RoverLabUNLP/PCB/poncho_original_mas_ancho/documentacion/README.md

# Documentación de referencia para el hardware

Copia desde el repositorio CIAA-firmware, incorporada el 02/11/2026 para
consultarla desde este proyecto. Son documentos de referencia y no se
sincronizan automáticamente con el repositorio de firmware.

- `edu-ciaa/`: dimensiones, esquemático y documentación de la EDU-CIAA-NXP,
  además de la hoja de datos y los manuales de la familia LPC43xx.
- `proyecto/`: informe de avance del auto remoto, que incluye componentes,
  conexiones y alimentación. Es una versión anterior y algunas decisiones
  pueden diferir del diseño actual.
- `firmware/`: copia de la guía de drivers y del mapa de pines del firmware.
  Comprobarlos contra el esquemático y la versión vigente del firmware antes
  de fabricar: pueden cambiar y no se actualizan automáticamente.
