RoverLabUNLP/PCB/poncho_original_mas_ancho/documentacion/pines-montaje.md

# Pines macho de P1 y P2

Montar los pines macho por debajo del poncho en estas posiciones. Se conservan
los agujeros y pads de los demás pines para mantener la compatibilidad con el
esquemático de KiCad; esos contactos se dejan sin montar.

- P1: 1, 2, 4, 7, 8, 10, 11, 12, 13, 14, 16, 18, 19, 20, 21, 22, 23, 24, 25, 26, 28, 30, 32, 35, 36, 38, 40.
- P2: 1, 2, 3, 5, 7, 11, 13, 17, 19, 22, 23, 24, 25, 26, 27, 28, 29, 30, 31, 32, 33, 34, 35, 36, 37, 38, 39, 40.

La selección incluye todos los pines conectados a alimentación o masa en el
esquemático, aunque varias masas compartan la misma red. Si cambia el uso de
pines, actualizar las huellas, sus modelos 3D y esta lista antes de fabricar.
