RoverLabUNLP/PCB/poncho_original_mas_ancho/auto_remoto.pdf

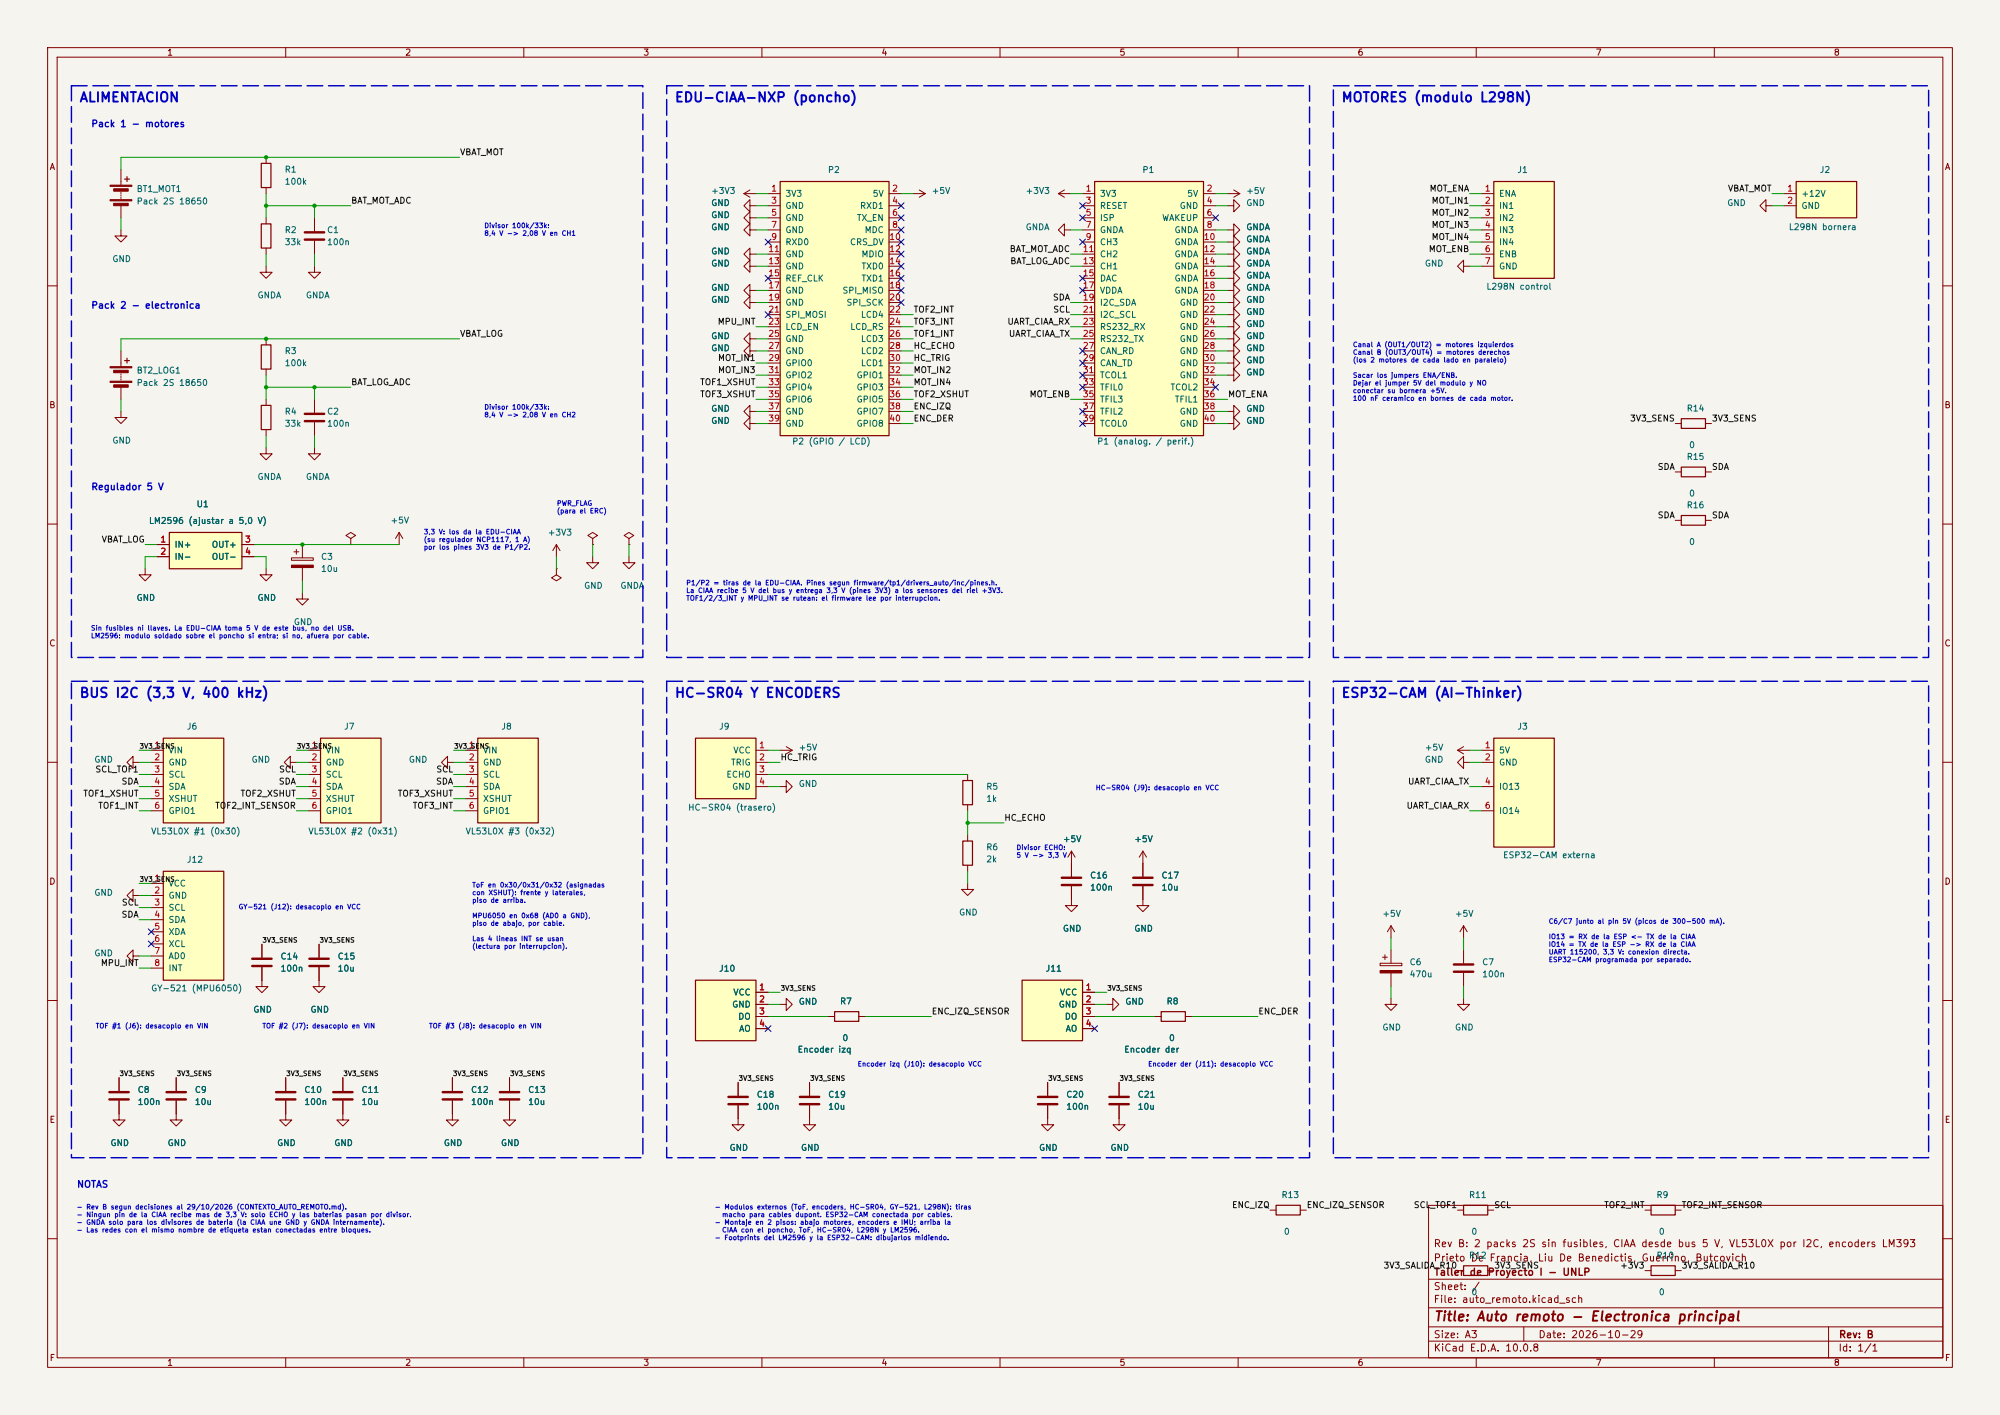
[picture p7: page 1]

EDU-CIAA-NXP (poncho)

GNDA GNDA GNDA GNDA GNDA
GNDA

Canal A (OUT1/OUT2) = motores izquierdos Canal B (OUT3/OUT4) = motores derechos

(los 2 motores de cada lado en paralelo) Sacar los jumpers ENA/ENB. Dejar el jumper 5V del modulo y NO

conectar su bornera +5V. 100 nF ceramico en bornes de cada motor. BUS I2C (3,3 V, 400 kHz)

(para el ERC) 3,3 V: los da la EDU-CIAA

ToF en 0x30/0x31/0x32 (asignadas con XSHUT): frente y laterales, piso de arriba. MPU6050 en 0x68 (AD0 a GND), piso de abajo, por cable. Las 4 lineas INT se usan

GY-521 (J12): desacoplo en VCC

C6/C7 junto al pin 5V (picos de 300-500 mA).

IO13 = RX de la ESP <- TX de la CIAA

TOF #2 (J7): desacoplo en VIN - Rev B segun decisiones al 29/10/2026 (CONTEXTO_AUTO_REMOTO.md). - Ningun pin de la CIAA recibe mas de 3,3 V: solo ECHO y las baterias pasan por divisor. - GNDA solo para los divisores de bateria (la CIAA une GND y GNDA internamente). - Las redes con el mismo nombre de etiqueta estan conectadas entre bloques.

TOF #3 (J8): desacoplo en VIN

Encoder der (J11): desacoplo VCC

Rev B: 2 packs 2S sin fusibles, CIAA desde bus 5 V, VL53L0X por I2C, encoders LM393
Prieto De Francia, Liu De Benedictis, Guerrino, Butcovich
Sheet: /
File: auto_remoto.kicad_sch
Title: Auto remoto - Electronica principal

Size: A3 | Rev: B | F Date: 2026-10-29
KiCad E.D.A. 10.0.8 | Id: 1/1
