RoverLabUNLP/PCB/poncho_original_mas_ancho/respaldo_antes_i2c_R15_R16/auto_remoto.pdf

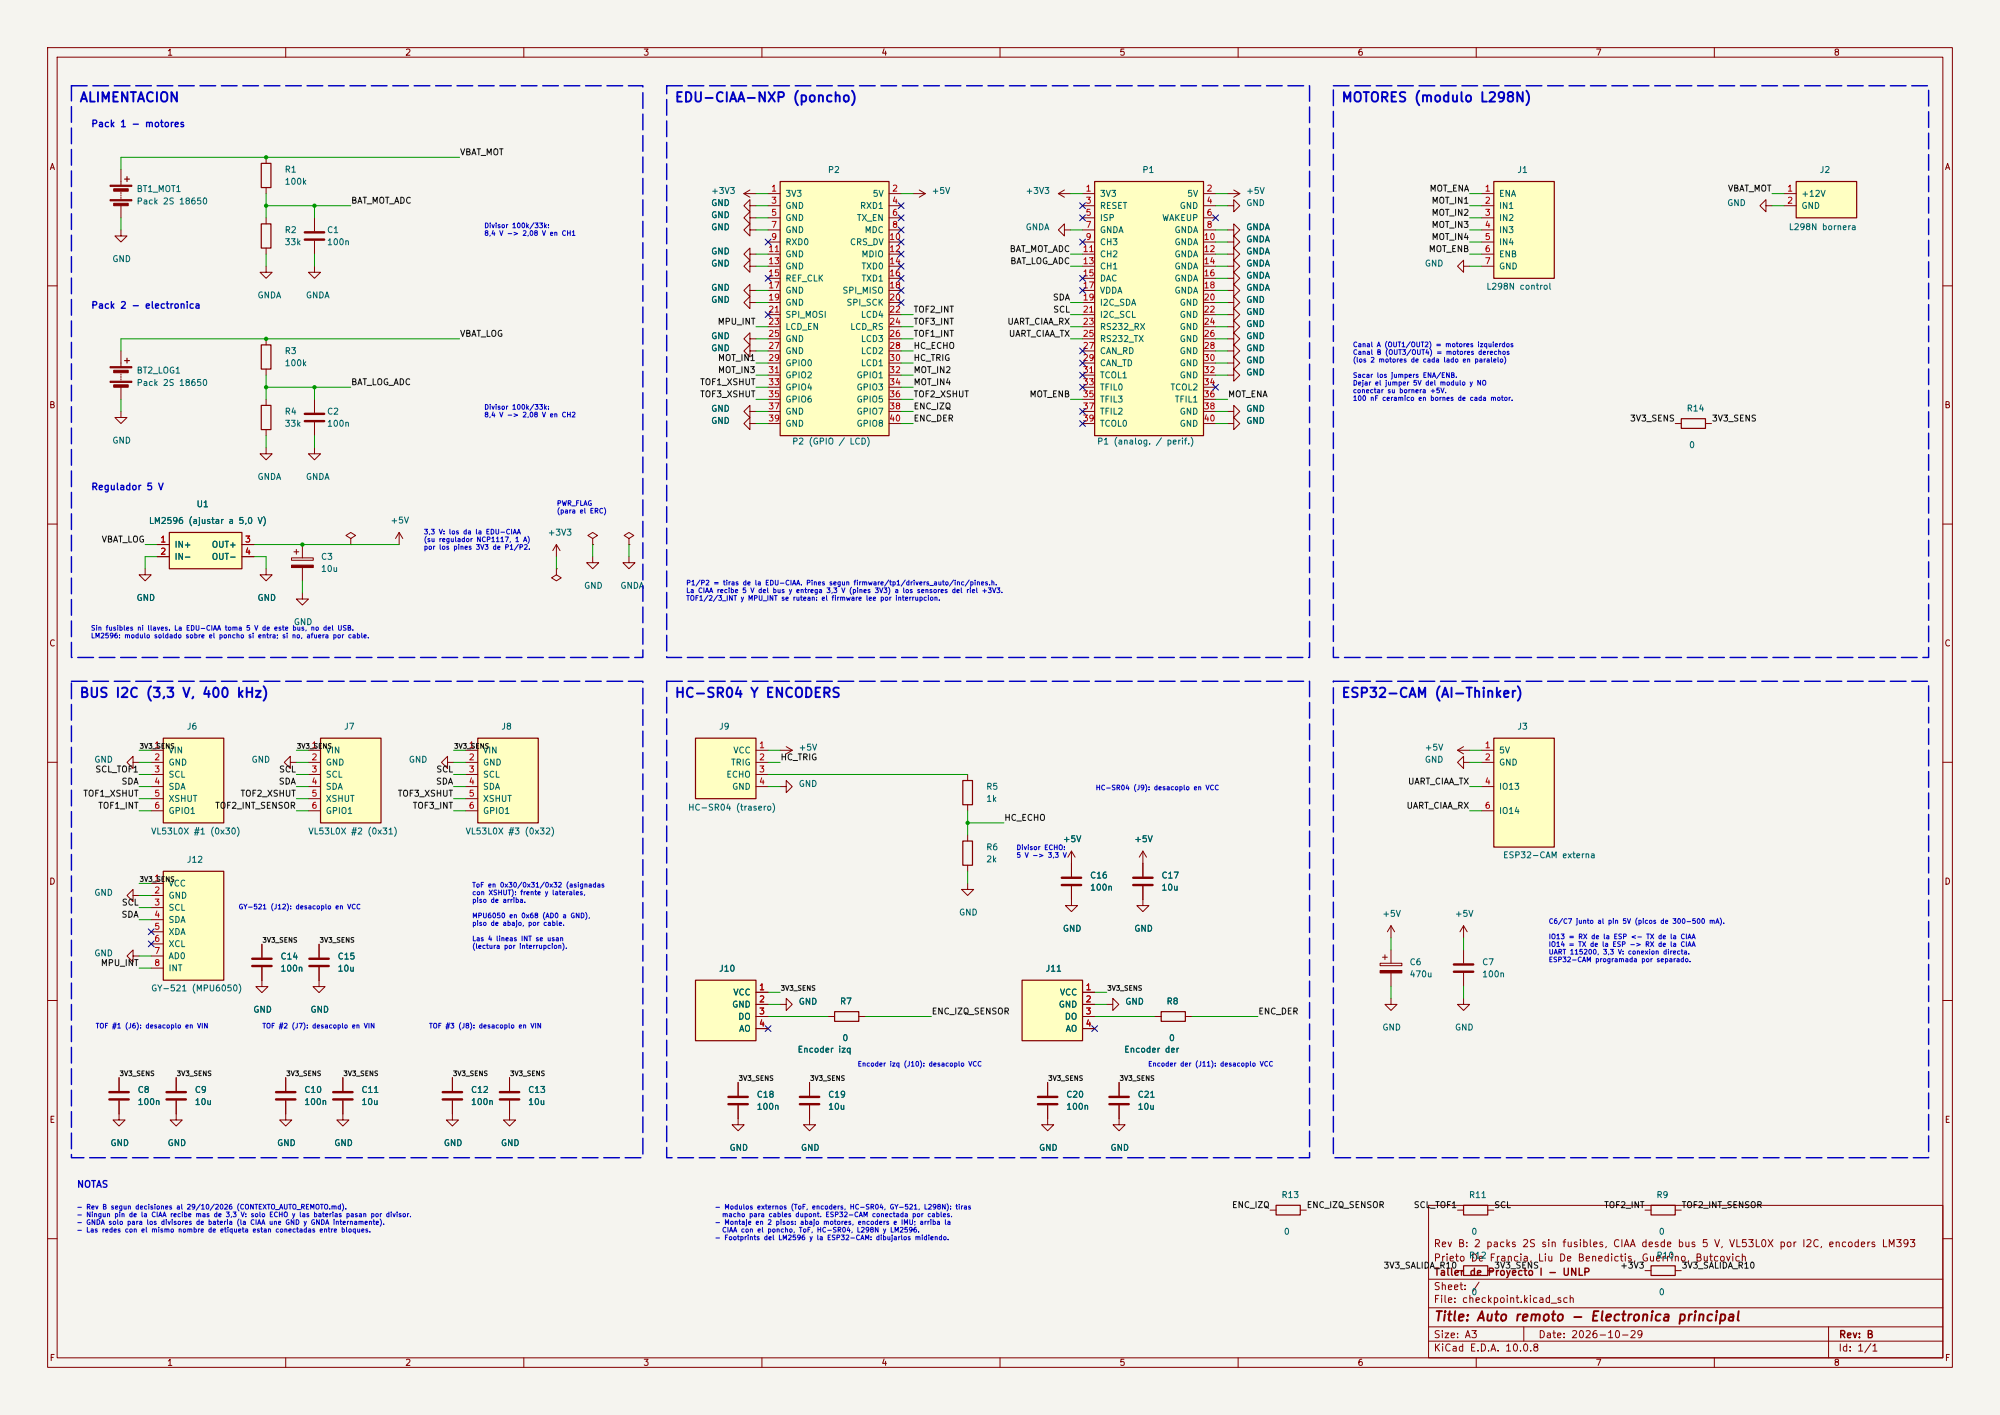
[picture p8: page 1]

P1/P2 = tiras de la EDU-CIAA. Pines segun firmware/tp1/drivers_auto/inc/pines.h. La CIAA recibe 5 V del bus y entrega 3,3 V (pines 3V3) a los sensores del riel +3V3. TOF1/2/3_INT y MPU_INT se rutean: el firmware lee por interrupcion. EDU-CIAA-NXP (poncho)

GND
GNDA GNDA GNDA GNDA GNDA GND

Canal A (OUT1/OUT2) = motores izquierdos Canal B (OUT3/OUT4) = motores derechos

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

conectar su bornera +5V. 100 nF ceramico en bornes de cada motor.

3,3 V: los da la EDU-CIAA
SCL 3
SDA 4

Sin fusibles ni llaves. La EDU-CIAA toma 5 V de este bus, no del USB. LM2596: modulo soldado sobre el poncho si entra; si no, afuera por cable.

TOF #2 (J7): desacoplo en VIN BUS I2C (3,3 V, 400 kHz)

IO14 = TX de la ESP -> RX de la CIAA UART 115200, 3,3 V: conexion directa. ESP32-CAM programada por separado. HC-SR04 (J9): desacoplo en VCC
10u +5V GND

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

GY-521 (J12): desacoplo en VCC

IO13 = RX de la ESP <- TX de la CIAA

TOF #1 (J6): desacoplo en VIN

Encoder der (J11): desacoplo VCC

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

Rev B: 2 packs 2S sin fusibles, CIAA desde bus 5 V, VL53L0X por I2C, encoders LM393
Prieto De Francia, Liu De Benedictis, Guerrino, Butcovich
Sheet: /
File: checkpoint.kicad_sch
Title: Auto remoto - Electronica principal

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
