RoverLabUNLP/PCB/poncho_original_mas_ancho/respaldo_antes_R10/auto_remoto.pdf

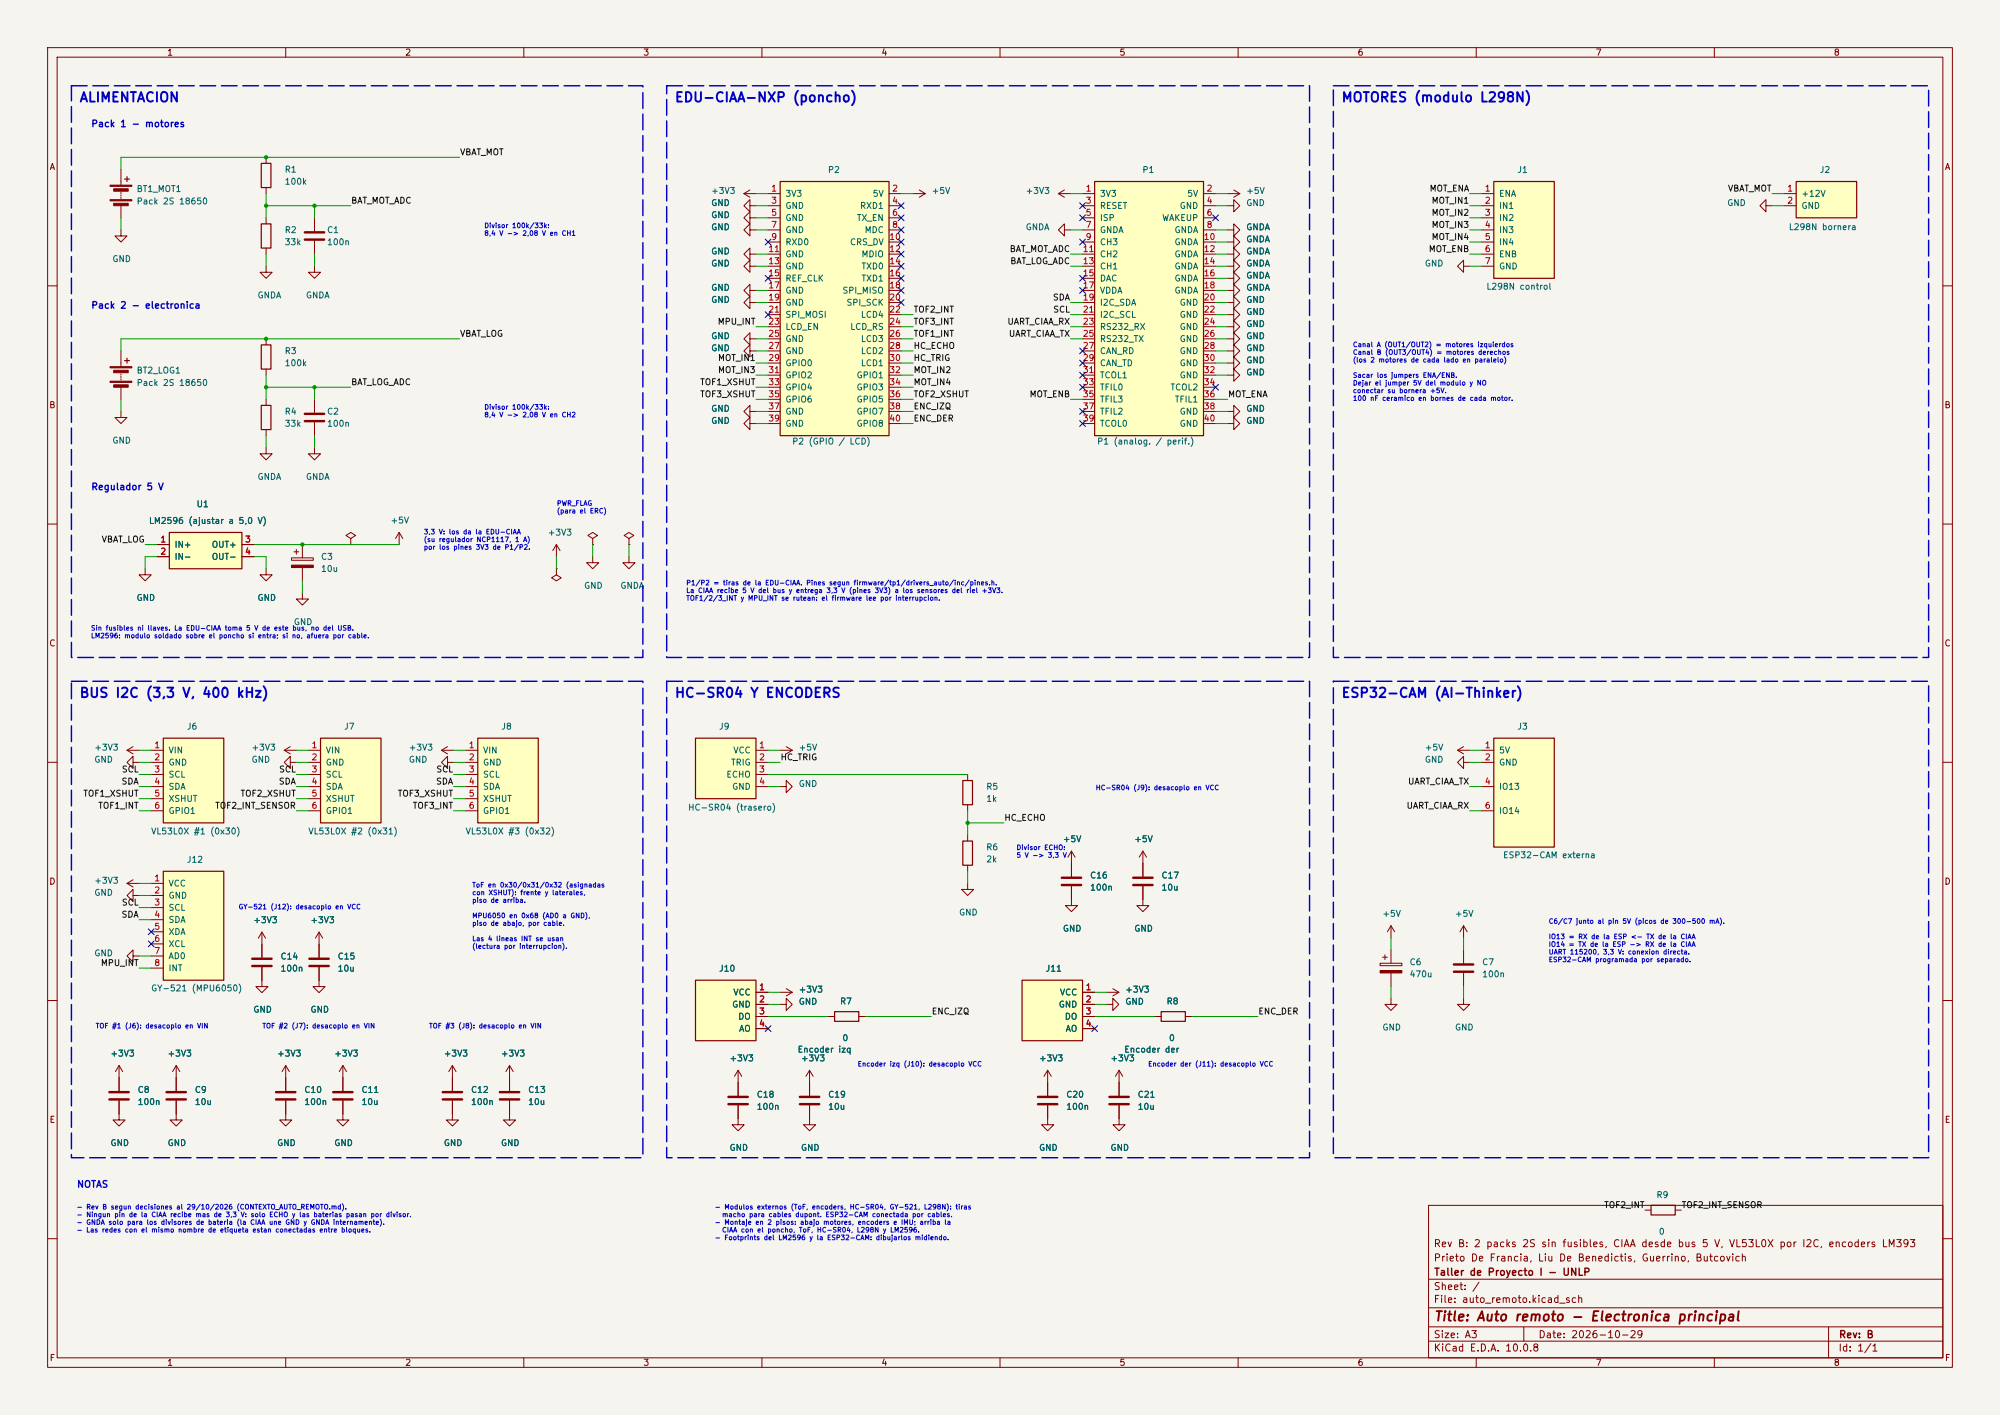
[picture p9: page 1]

Canal A (OUT1/OUT2) = motores izquierdos Canal B (OUT3/OUT4) = motores derechos

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

conectar su bornera +5V. 100 nF ceramico en bornes de cada motor.

3,3 V: los da la EDU-CIAA

IO14 = TX de la ESP -> RX de la CIAA UART 115200, 3,3 V: conexion directa. ESP32-CAM programada por separado. - Modulos externos (ToF, encoders, HC-SR04, GY-521, L298N): tiras macho para cables dupont. ESP32-CAM conectada por cables. - Montaje en 2 pisos: abajo motores, encoders e IMU; arriba la CIAA con el poncho, ToF, HC-SR04, L298N y LM2596. - Footprints del LM2596 y la ESP32-CAM: dibujarlos midiendo. HC-SR04 Y ENCODERS

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

TOF #1 (J6): desacoplo en VIN - Rev B segun decisiones al 29/10/2026 (CONTEXTO_AUTO_REMOTO.md). - Ningun pin de la CIAA recibe mas de 3,3 V: solo ECHO y las baterias pasan por divisor. - GNDA solo para los divisores de bateria (la CIAA une GND y GNDA internamente). - Las redes con el mismo nombre de etiqueta estan conectadas entre bloques. GY-521 (J12): desacoplo en VCC

C6/C7 junto al pin 5V (picos de 300-500 mA).

IO13 = RX de la ESP <- TX de la CIAA

TOF #3 (J8): desacoplo en VIN

Rev B: 2 packs 2S sin fusibles, CIAA desde bus 5 V, VL53L0X por I2C, encoders LM393
Prieto De Francia, Liu De Benedictis, Guerrino, Butcovich
Taller de Proyecto I - UNLP
Sheet: /
File: auto_remoto.kicad_sch
Title: Auto remoto - Electronica principal

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
