RoverLabUNLP/PCB/poncho_original_mas_ancho/respaldo_antes_R9/auto_remoto.pdf

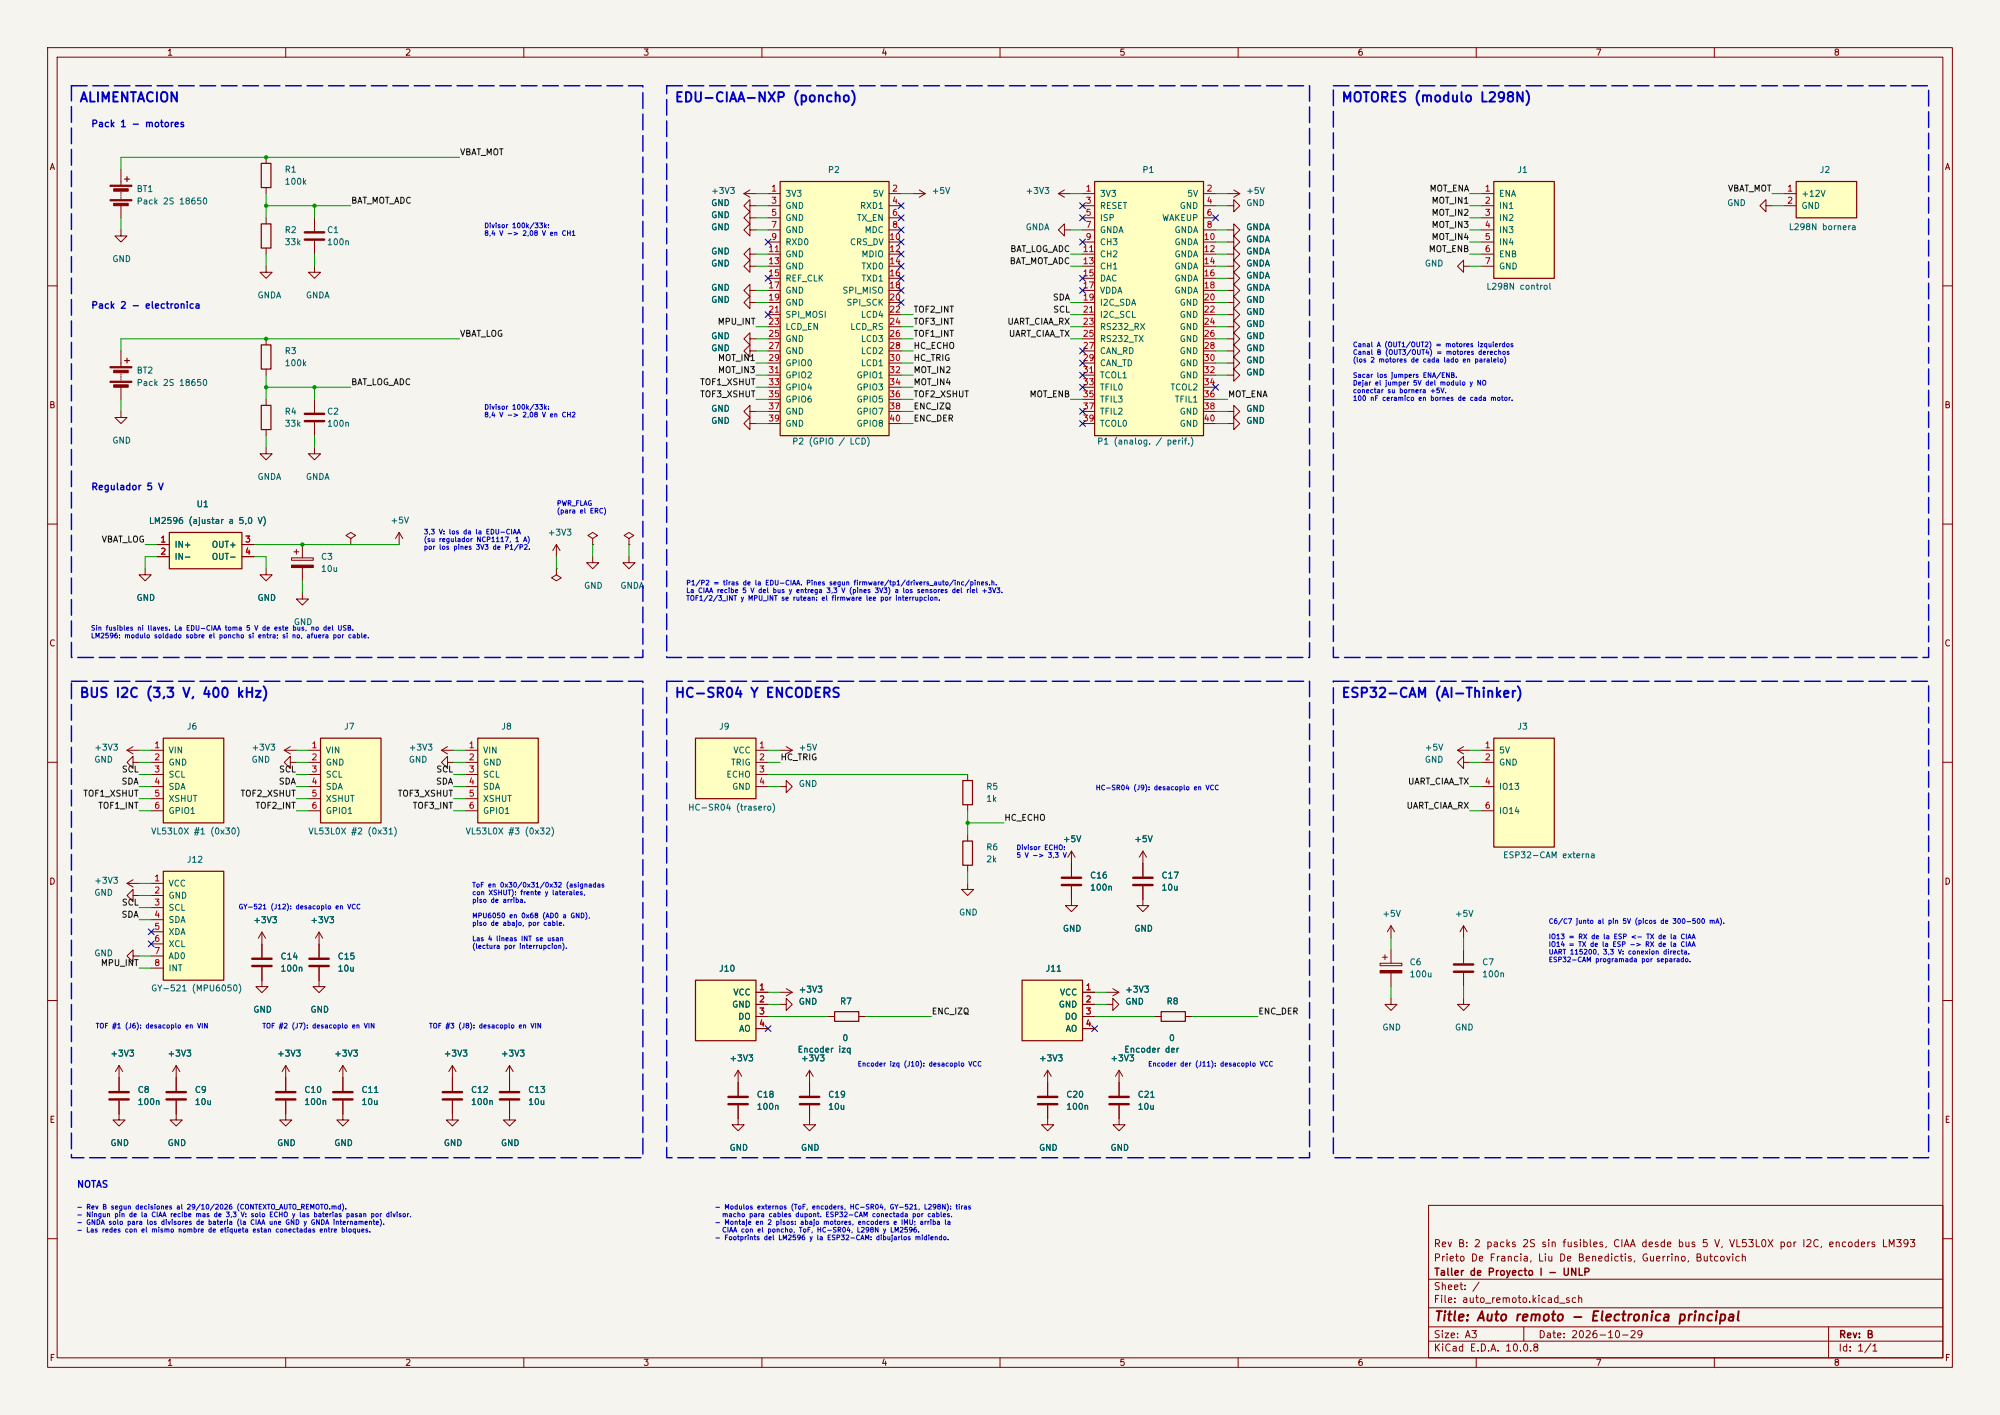
[picture p10: page 1]

EDU-CIAA-NXP (poncho)

conectar su bornera +5V. 100 nF ceramico en bornes de cada motor. MOTORES (modulo L298N)

GND
GNDA GND
GNDA GNDA GNDA GND

GNDA GNDA GNDA GNDA GNDA GND

Canal A (OUT1/OUT2) = motores izquierdos Canal B (OUT3/OUT4) = motores derechos

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

(su regulador NCP1117, 1 A) por los pines 3V3 de P1/P2. Divisor 100k/33k: 8,4 V -> 2,08 V en CH2 PWR_FLAG

3,3 V: los da la EDU-CIAA

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

HC-SR04 (J9): desacoplo en VCC

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

GY-521 (J12): desacoplo en VCC

C6/C7 junto al pin 5V (picos de 300-500 mA).

IO13 = RX de la ESP <- TX de la CIAA

IO14 = TX de la ESP -> RX de la CIAA UART 115200, 3,3 V: conexion directa. ESP32-CAM programada por separado. Encoder der (J11): desacoplo VCC

TOF #1 (J6): desacoplo en VIN

TOF #2 (J7): desacoplo en VIN

TOF #3 (J8): desacoplo en VIN

Encoder izq C18
Encoder izq (J10): desacoplo VCC - Modulos externos (ToF, encoders, HC-SR04, GY-521, L298N): tiras macho para cables dupont. ESP32-CAM conectada por cables. - Montaje en 2 pisos: abajo motores, encoders e IMU; arriba la CIAA con el poncho, ToF, HC-SR04, L298N y LM2596. - Footprints del LM2596 y la ESP32-CAM: dibujarlos midiendo.

- Rev B segun decisiones al 29/10/2026 (CONTEXTO_AUTO_REMOTO.md). - Ningun pin de la CIAA recibe mas de 3,3 V: solo ECHO y las baterias pasan por divisor. - GNDA solo para los divisores de bateria (la CIAA une GND y GNDA internamente). - Las redes con el mismo nombre de etiqueta estan conectadas entre bloques. NOTAS

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
