RoverLabUNLP/PCB/poncho_original_mas_ancho/documentacion/edu-ciaa/EDU-CIAA-NXP Esquematico_v2.pdf

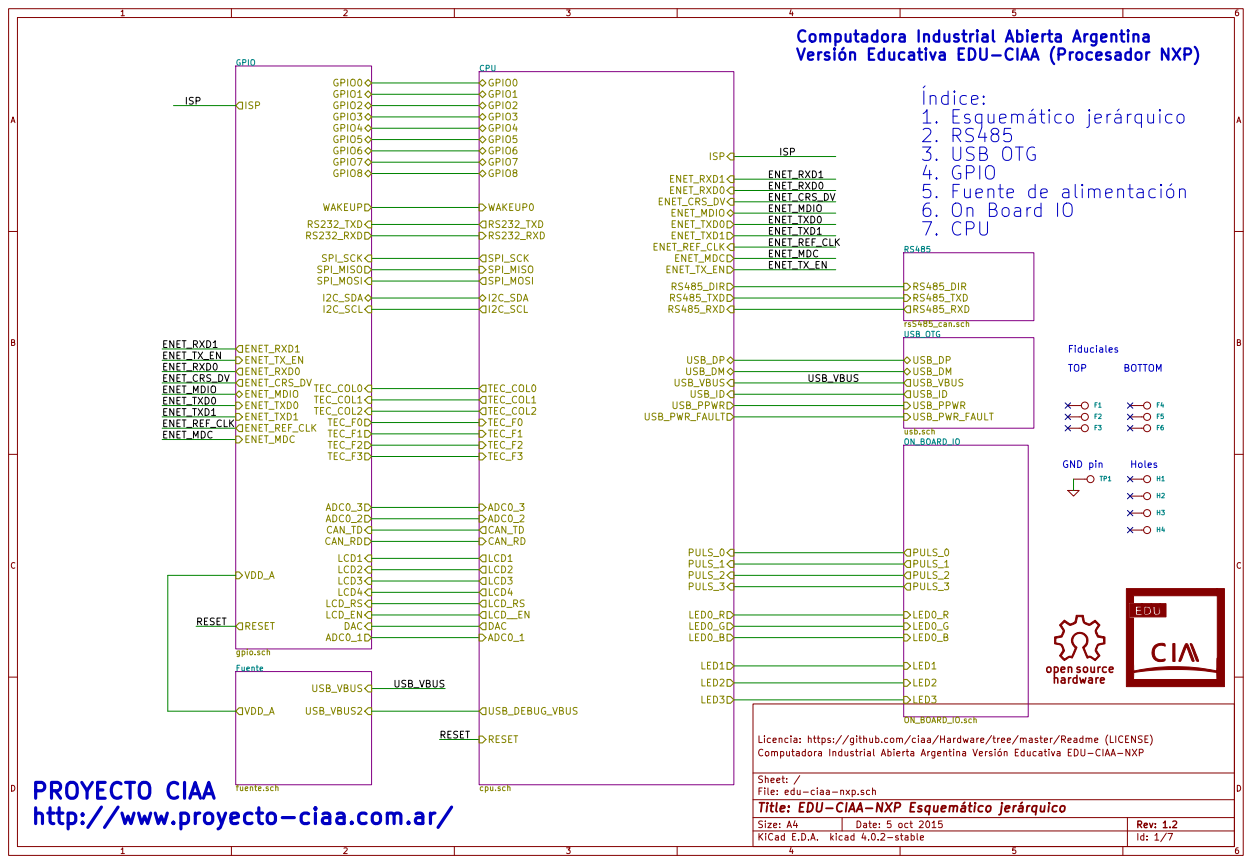
[picture p11: page 1]

LED3 Computadora Industrial Abierta Argentina
Versión Educativa EDU-CIAA (Procesador NXP)

ENET_RXD0
ENET_CRS_DV

ENET_TX_EN
ENET_MDIO
ENET_TXD0
ENET_TXD1
ENET_REF_CLK
ENET_MDC

Licencia: https://github.com/ciaa/Hardware/tree/master/Readme (LICENSE)
File: edu-ciaa-nxp.sch Sheet: / Computadora Industrial Abierta Argentina Versión Educativa EDU-CIAA-NXP

PROYECTO CIAA
http://www.proyecto-ciaa.com.ar/

Id: 1/7 Title: EDU-CIAA-NXP Esquemático jerárquico

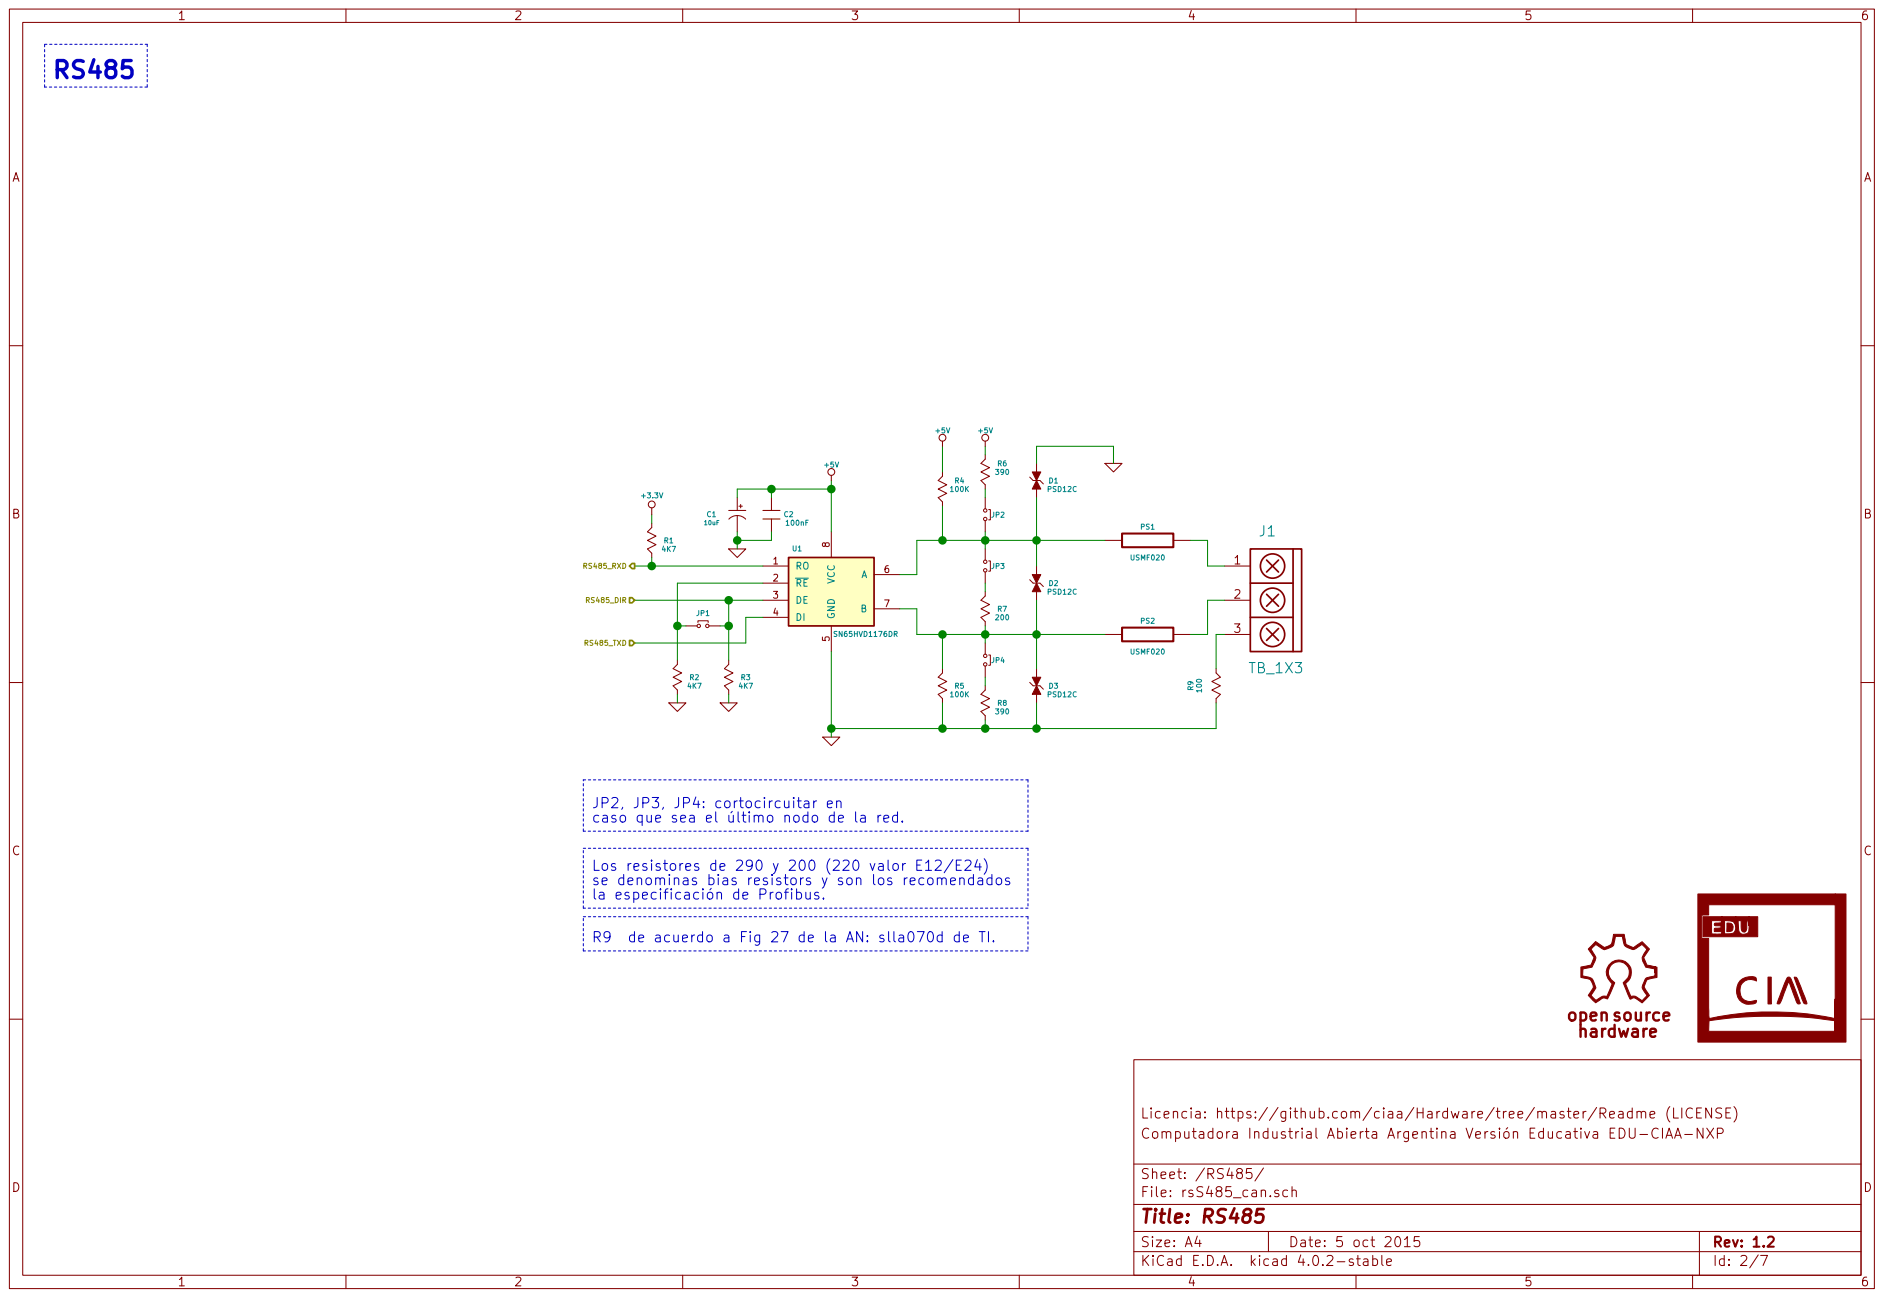
[picture p12: page 2]

la especificación de Profibus. R1
4K7 RS485_TXD

caso que sea el último nodo de la red. R3

Los resistores de 290 y 200 (220 valor E12/E24)
se denominas bias resistors y son los recomendados

open source R9 de acuerdo a Fig 27 de la AN: slla070d de TI.

Licencia: https://github.com/ciaa/Hardware/tree/master/Readme (LICENSE)
File: rsS485_can.sch Sheet: /RS485/ Computadora Industrial Abierta Argentina Versión Educativa EDU-CIAA-NXP

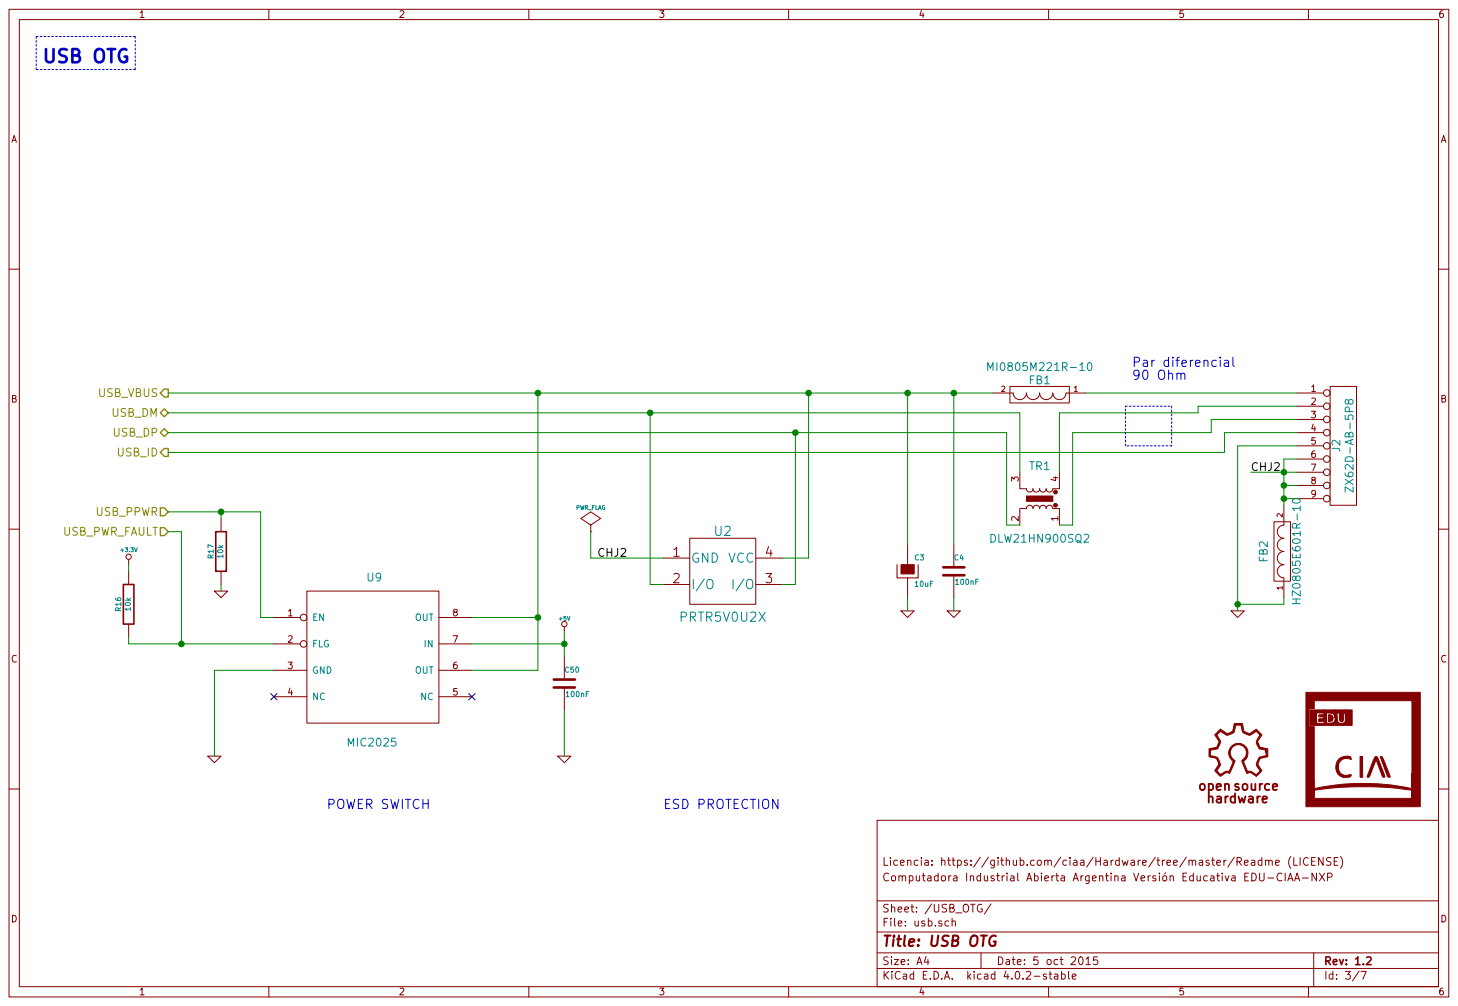
[picture p13: page 3]

open source USB OTG

Licencia: https://github.com/ciaa/Hardware/tree/master/Readme (LICENSE)
Computadora Industrial Abierta Argentina Versión Educativa EDU-CIAA-NXP

File: usb.sch Sheet: /USB_OTG/
Id: 3/7 Title: USB OTG

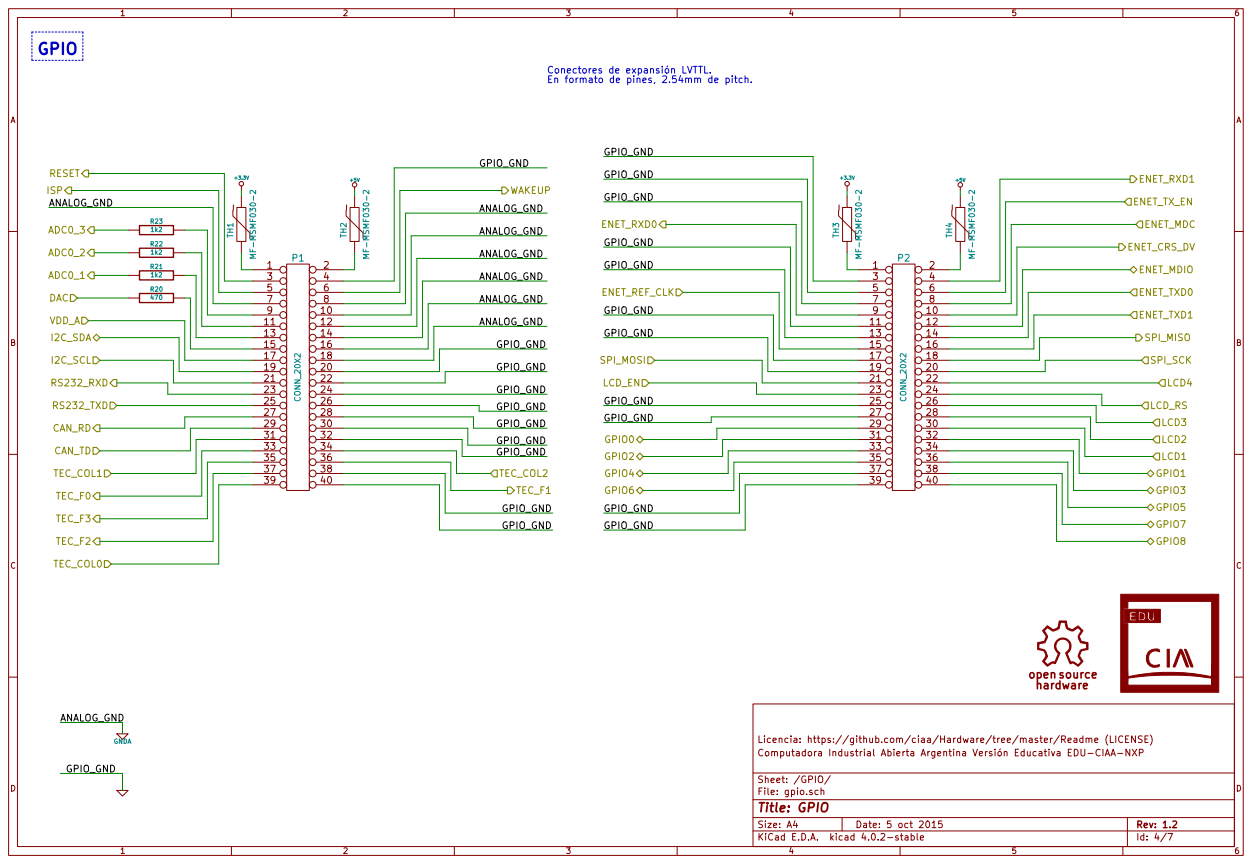
[picture p14: page 4]

Conectores de expansión LVTTL.
En formato de pines, 2.54mm de pitch.

Licencia: https://github.com/ciaa/Hardware/tree/master/Readme (LICENSE)
File: gpio.sch Sheet: /GPIO/ Computadora Industrial Abierta Argentina Versión Educativa EDU-CIAA-NXP

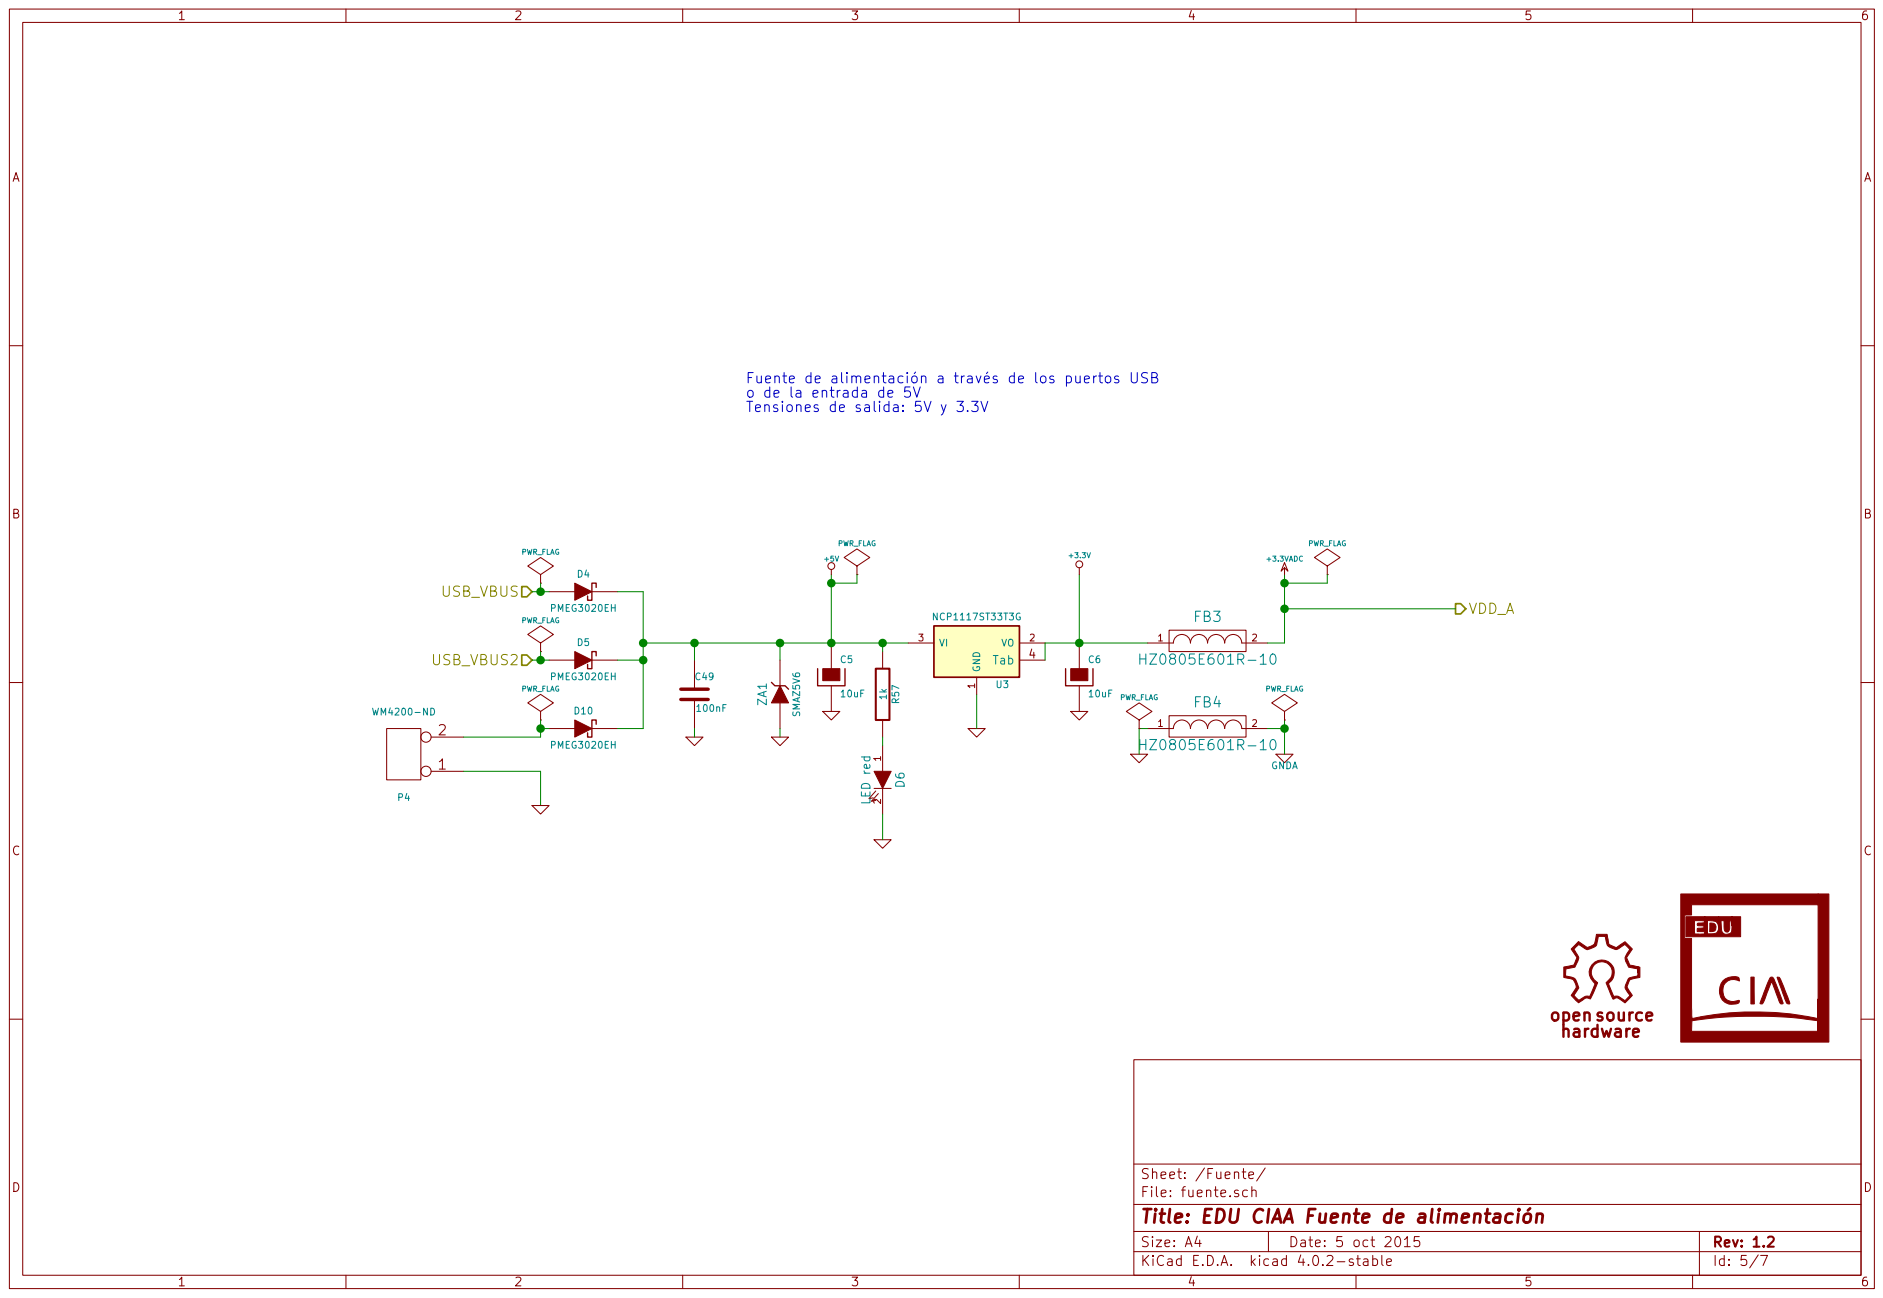
[picture p15: page 5]

1 2 D6 LED red R57 1k Fuente de alimentación a través de los puertos USB
o de la entrada de 5V Tensiones de salida: 5V y 3.3V

File: fuente.sch Sheet: /Fuente/
Id: 5/7 Title: EDU CIAA Fuente de alimentación

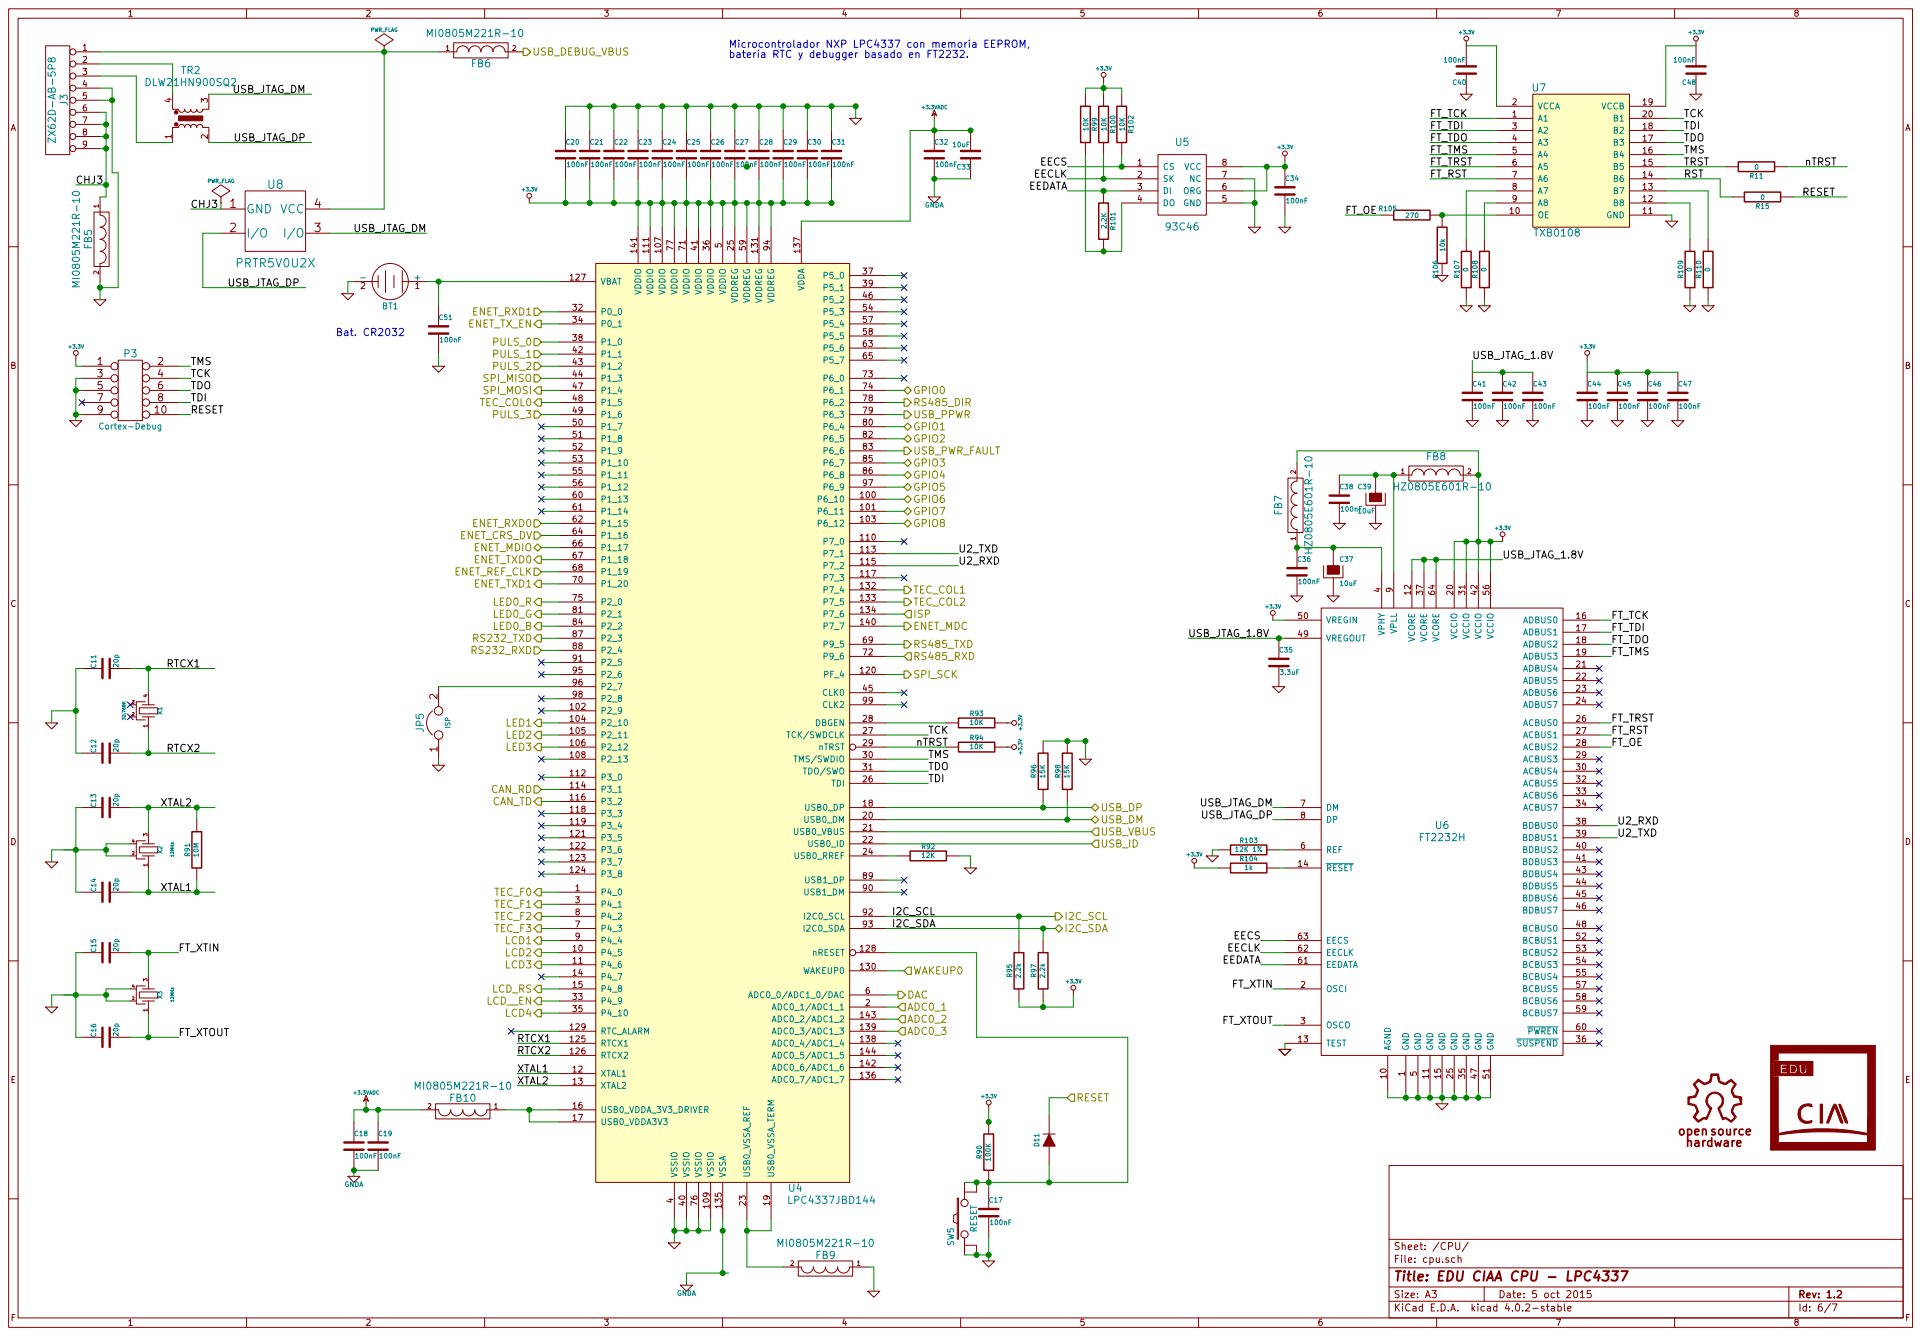
[picture p16: page 6]

batería RTC y debugger basado en FT2232.

FT_TMS | 20 GND 16 B3

FT_TRST | | 15 B4
FT_RST | 14 B5

5 ADC0_0/ADC1_0/DAC 6 P4_3 7 P4_2 8 P4_4 9 P4_5 10 USB0_DM 20 TMS/SWDIO 30 VSSIO 40 P1_7 50 P1_13 60 P1_20 70 P6_4 80 USB1_DM 90 P4_6 11 USB0_VBUS 21 TDO/SWO 31 VDDIO 41 P1_8 51 P1_14 61 VDDIO 71 P2_1 81 P2_5 91 XTAL1 12 USB0_ID 22

9 AGND 10 VCCIO 20 ACBUS4 30 BDBUS2 40 VREGIN 50 PWREN 60 GND 11 ADBUS4 21 VCCIO 31 BDBUS3 41 GND 51 EEDATA 61 VCORE 12 ADBUS5 22 ACBUS5 32 VCCIO 42 BCBUS1 52 EECLK 62 TEST 13 ADBUS6 23 ACBUS6 33 BDBUS4 43 BCBUS2 53 EECS 63 RESET 14 ADBUS7 24 ACBUS7 34 BDBUS5 44 BCBUS3 54 VCORE 64 GND 15 GND 25 GND 35 BDBUS6 45 BCBUS4 55 ADBUS0 16 ACBUS0 26 SUSPEND 36 BDBUS7 46 VCCIO 56 ADBUS1 17 ACBUS1 27 VCORE 37 GND 47 BCBUS5 57 ADBUS2 18 ACBUS2 28 BDBUS0 38 BCBUS0 48 BCBUS6 58 ADBUS3 19 ACBUS3 29 BDBUS1 39 VREGOUT 49 BCBUS7 59 U6 FT2232H

5 REF 6 DM 7 DP 8 VPLL

File: cpu.sch Sheet: /CPU/
Id: 6/7 Title: EDU CIAA CPU - LPC4337

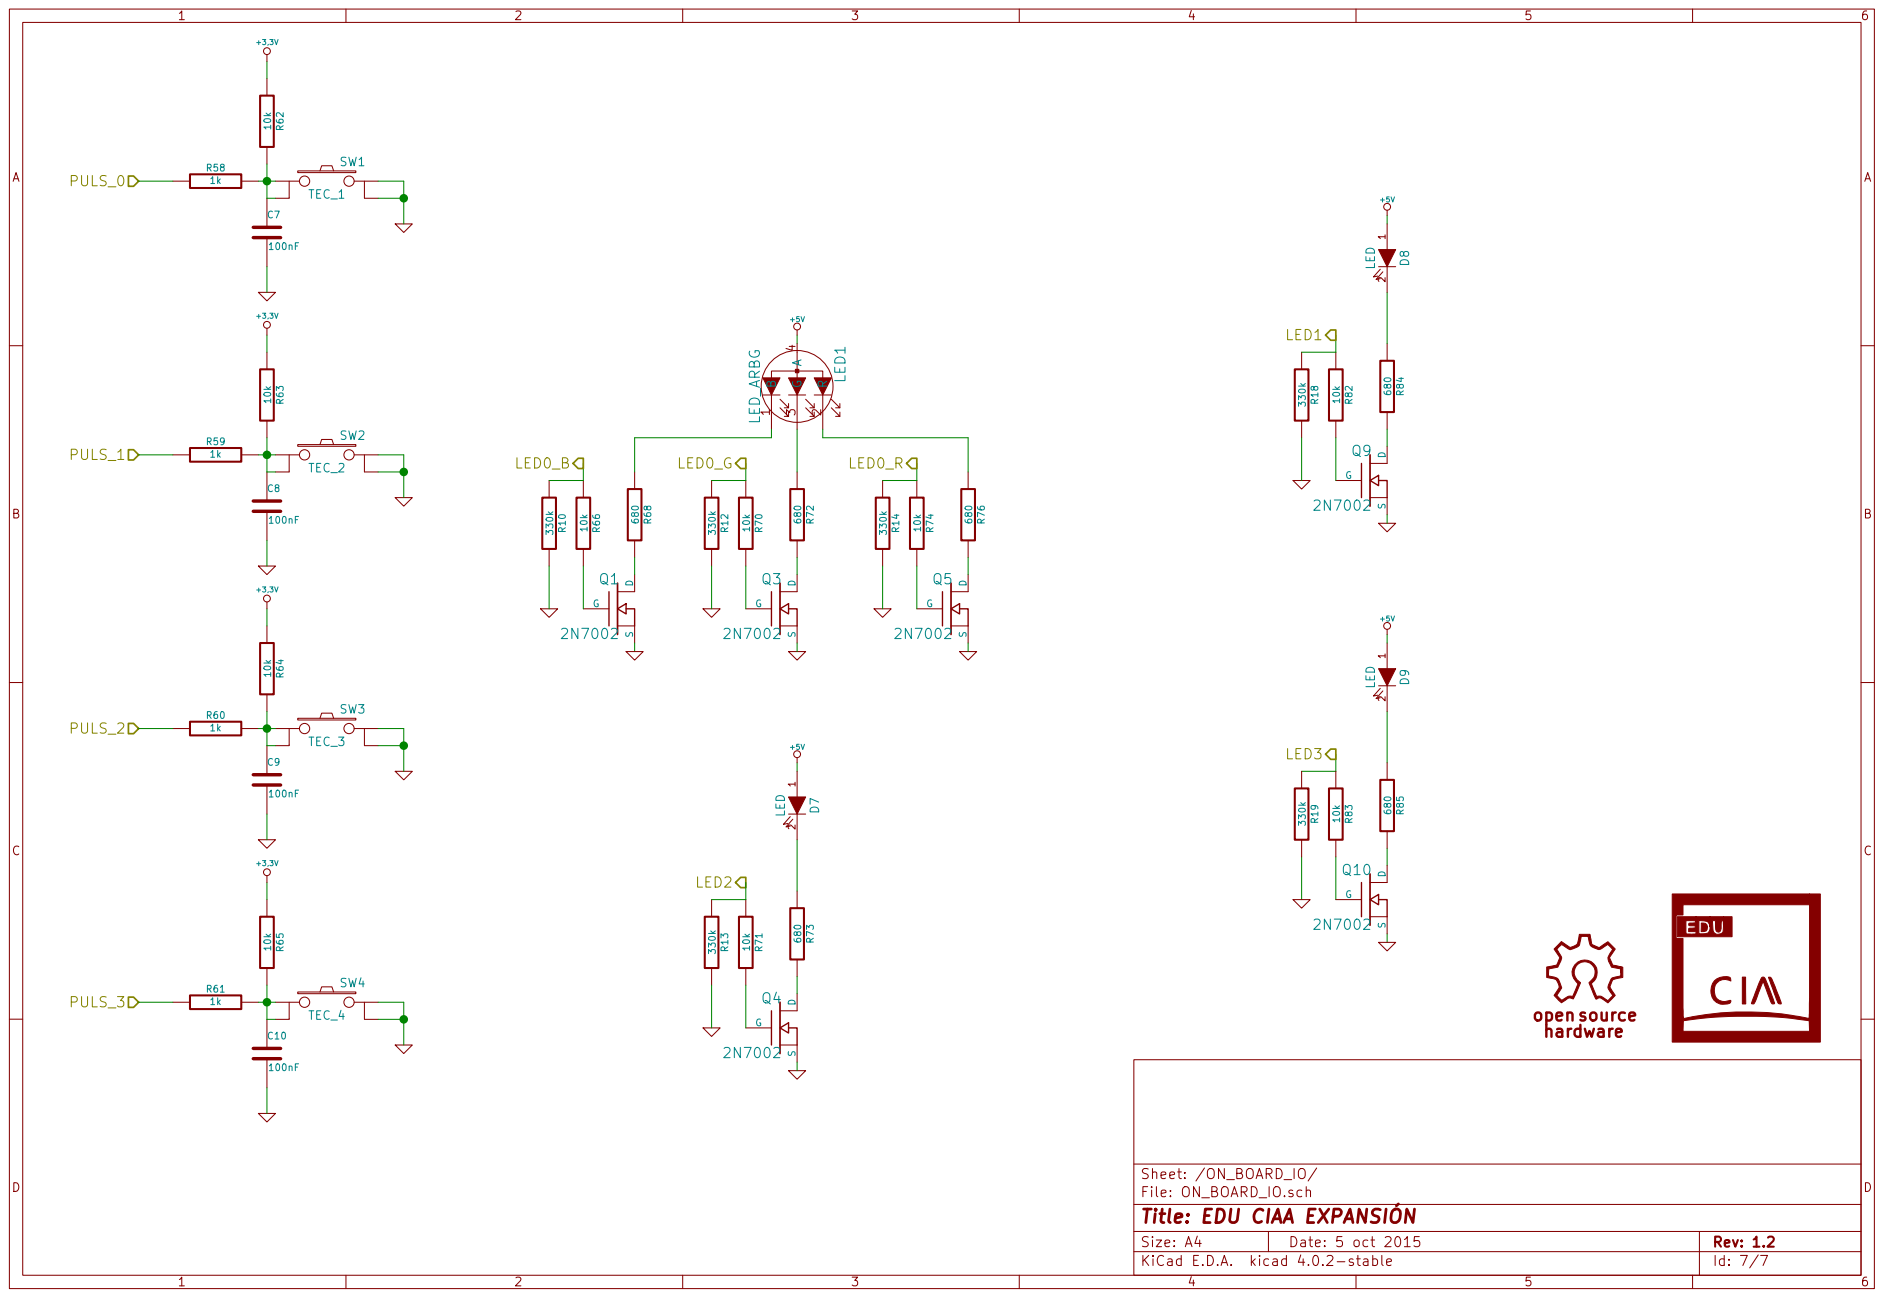
[picture p17: page 7]

Sheet: /ON_BOARD_IO/
File: ON_BOARD_IO.sch
Id: 7/7 Title: EDU CIAA EXPANSIÓN
