RoverLabUNLP/PCB/poncho_original_mas_ancho/respaldo_antes_R14_3v3/auto_remoto.kicad_pcb

## KiCad design poncho_original_mas_ancho/respaldo_antes_R14_3v3/auto_remoto.kicad_pcb (2026-11-05)

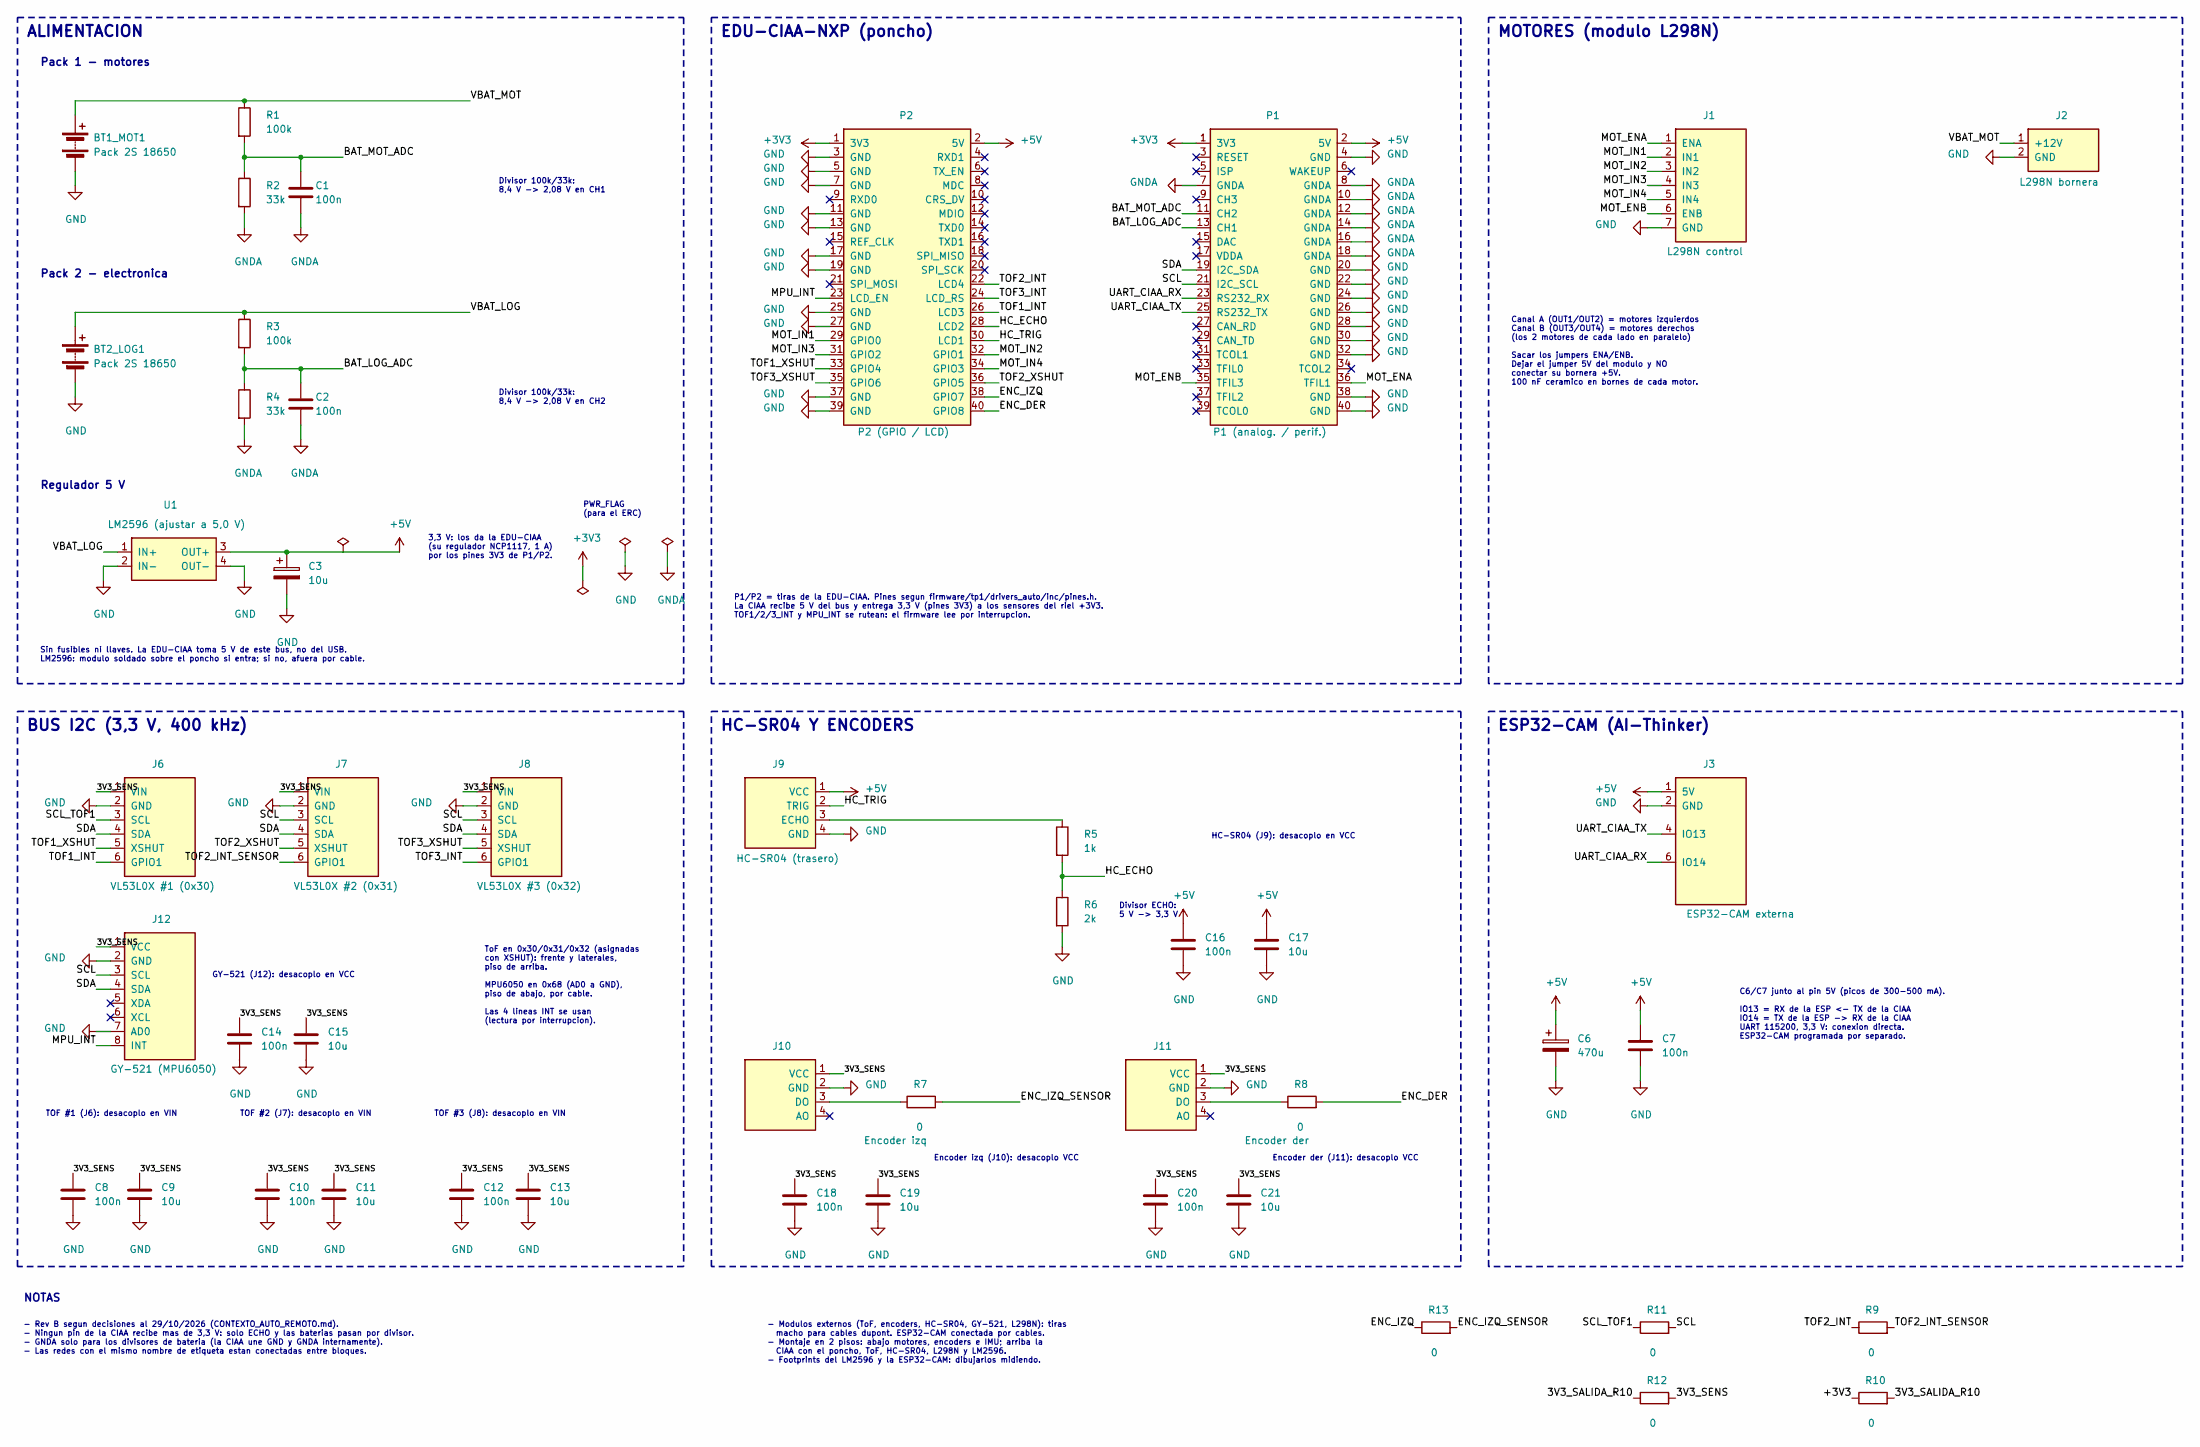
[picture p22: schematic auto_remoto.kicad_sch, Auto remoto - Electronica principal]

Parts:
BT1_MOT1, BT2_LOG1: Pack 2S 18650; Bornera_2_P5.00
C1, C2, C7, C8, C10, C12, C14, C16, C18, C20: 100n; C_P5.00
C3: 10u; CP_D6.3_P2.50
C6: 470u; CP_D6.3_P2.50
C9, C11, C13, C15, C17, C19, C21: 10u; C_P5.00
J1: L298N control; Tira_1x07
J2: L298N bornera; Bornera_2_P5.00
J3: ESP32-CAM externa; Pads_ESP32_CAM
J6: VL53L0X #1 (0x30); Tira_1x06
J7: VL53L0X #2 (0x31); Tira_1x06
J8: VL53L0X #3 (0x32); Tira_1x06
J9: HC-SR04 (trasero); Tira_1x04
J10: Encoder izq; Tira_1x04
J11: Encoder der; Tira_1x04
J12: GY-521 (MPU6050); Tira_1x08
P1: P1 (analog. / perif.); Tira_2x20_CIAA_P1
P2: P2 (GPIO / LCD); Tira_2x20_CIAA_P2
R1, R3: 100k; R_P10.16
R2, R4: 33k; R_P10.16
R5: 1k; R_P10.16
R6: 2k; R_P10.16
R7, R8, R9, R10, R11, R12, R13: 0; R_P10.16
U1: LM2596 (ajustar a 5,0 V); Modulo_LM2596

Connections:
+3V3: P1.1 (3V3), P2.1 (3V3), R10.1
+5V: C3.1, C6.1, C7.1, C16.1, C17.1, J3.1 (5V), J9.1 (VCC), P1.2 (5V), P2.2 (5V), U1.3 (OUT+)
/3V3_SALIDA_R10: R10.2, R12.1
/3V3_SENS: C8.1, C9.1, C10.1, C11.1, C12.1, C13.1, C14.1, C15.1, C18.1, C19.1, C20.1, C21.1, J6.1 (VIN), J7.1 (VIN), J8.1 (VIN), J10.1 (VCC), J11.1 (VCC), J12.1 (VCC), R12.2
/BAT_LOG_ADC: C2.1, P1.13 (CH1), R3.2, R4.1
/BAT_MOT_ADC: C1.1, P1.11 (CH2), R1.2, R2.1
/ENC_DER: P2.40 (GPIO8), R8.2
/ENC_IZQ: P2.38 (GPIO7), R13.1
/ENC_IZQ_SENSOR: R7.2, R13.2
/HC_ECHO: P2.28 (LCD2), R5.2, R6.1
/HC_TRIG: J9.2 (TRIG), P2.30 (LCD1)
/MOT_ENA: J1.1 (ENA), P1.36 (TFIL1)
/MOT_ENB: J1.6 (ENB), P1.35 (TFIL3)
/MOT_IN1: J1.2 (IN1), P2.29 (GPIO0)
/MOT_IN2: J1.3 (IN2), P2.32 (GPIO1)
/MOT_IN3: J1.4 (IN3), P2.31 (GPIO2)
/MOT_IN4: J1.5 (IN4), P2.34 (GPIO3)
/MPU_INT: J12.8 (INT), P2.23 (LCD_EN)
/SCL: J7.3 (SCL), J8.3 (SCL), J12.3 (SCL), P1.21 (I2C_SCL), R11.2
/SCL_TOF1: J6.3 (SCL), R11.1
/SDA: J6.4 (SDA), J7.4 (SDA), J8.4 (SDA), J12.4 (SDA), P1.19 (I2C_SDA)
/TOF1_INT: J6.6 (GPIO1), P2.26 (LCD3)
/TOF1_XSHUT: J6.5 (XSHUT), P2.33 (GPIO4)
/TOF2_INT: P2.22 (LCD4), R9.1
/TOF2_INT_SENSOR: J7.6 (GPIO1), R9.2
/TOF2_XSHUT: J7.5 (XSHUT), P2.36 (GPIO5)
/TOF3_INT: J8.6 (GPIO1), P2.24 (LCD_RS)
/TOF3_XSHUT: J8.5 (XSHUT), P2.35 (GPIO6)
/UART_CIAA_RX: J3.6 (IO14), P1.23 (RS232_RX)
/UART_CIAA_TX: J3.4 (IO13), P1.25 (RS232_TX)
/VBAT_LOG: BT2_LOG1.1 (+), R3.1, U1.1 (IN+)
/VBAT_MOT: BT1_MOT1.1 (+), J2.1 (+12V), R1.1
GND: BT1_MOT1.2 (-), BT2_LOG1.2 (-), C3.2, C6.2, C7.2, C8.2, C9.2, C10.2, C11.2, C12.2, C13.2, C14.2, C15.2, C16.2, C17.2, C18.2, C19.2, C20.2, C21.2, J1.7 (GND), J2.2 (GND), J3.2 (GND), J6.2 (GND), J7.2 (GND), J8.2 (GND), J9.4 (GND), J10.2 (GND), J11.2 (GND), J12.2 (GND), J12.7 (AD0), P1.4 (GND), P1.20 (GND), P1.22 (GND), P1.24 (GND), P1.26 (GND), P1.28 (GND), P1.30 (GND), P1.32 (GND), P1.38 (GND), P1.40 (GND), P2.3 (GND), P2.5 (GND), P2.7 (GND), P2.11 (GND), P2.13 (GND), P2.17 (GND), P2.19 (GND), P2.25 (GND), P2.27 (GND), P2.37 (GND), P2.39 (GND), R6.2, U1.2 (IN-), U1.4 (OUT-)
GNDA: C1.2, C2.2, P1.7 (GNDA), P1.8 (GNDA), P1.10 (GNDA), P1.12 (GNDA), P1.14 (GNDA), P1.16 (GNDA), P1.18 (GNDA), R2.2, R4.2
unnamed: J9.3 (ECHO), R5.1
unnamed: J10.3 (DO), R7.1
unnamed: J11.3 (DO), R8.1

Notes on the sheet:
Encoder izq (J10): desacoplo VCC
Regulador 5 V
HC-SR04 (J9): desacoplo en VCC
MOTORES (modulo L298N)
Pack 2 - electronica
ESP32-CAM (AI-Thinker)
HC-SR04 Y ENCODERS
GY-521 (J12): desacoplo en VCC
Divisor 100k/33k: 8,4 V -> 2,08 V en CH1
PWR_FLAG (para el ERC)
Encoder der (J11): desacoplo VCC
Sin fusibles ni llaves. La EDU-CIAA toma 5 V de este bus, no del USB. LM2596: modulo soldado sobre el poncho si entra; si no, afuera por cable.
BUS I2C (3,3 V, 400 kHz)
TOF #3 (J8): desacoplo en VIN
Pack 1 - motores
3,3 V: los da la EDU-CIAA (su regulador NCP1117, 1 A) por los pines 3V3 de P1/P2.
TOF #2 (J7): desacoplo en VIN
C6/C7 junto al pin 5V (picos de 300-500 mA). IO13 = RX de la ESP <- TX de la CIAA IO14 = TX de la ESP -> RX de la CIAA UART 115200, 3,3 V: conexion directa. ESP32-CAM programada por separado.
EDU-CIAA-NXP (poncho)
- Rev B segun decisiones al 29/10/2026 (CONTEXTO_AUTO_REMOTO.md). - Ningun pin de la CIAA recibe mas de 3,3 V: solo ECHO y las baterias pasan por divisor. - GNDA solo para los divisores de bateria (la CIAA une GND y GNDA internamente). - Las redes con el mismo nombre de etiqueta estan conectadas en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
NOTAS
ALIMENTACION
Divisor ECHO: 5 V -> 3,3 V
P1/P2 = tiras de la EDU-CIAA. Pines segun firmware/tp1/drivers_auto/inc/pines.h. La CIAA recibe 5 V del bus y entrega 3,3 V (pines 3V3) a los sensores del riel +3V3. TOF1/2/3_INT y MPU_INT se rutean: el firmware lee por interrupcion.
- Modulos externos (ToF, encoders, HC-SR04, GY-521, L298N): tiras macho para cables dupont. ESP32-CAM conectada por cables. - Montaje en 2 pisos: abajo motores, encoders e IMU; arriba la CIAA con el poncho, ToF, HC-SR04, L298N y LM2596. - Footprints del LM2596 y la ESP32-CAM: dibujarlos midiendo.
TOF #1 (J6): desacoplo en VIN
Divisor 100k/33k: 8,4 V -> 2,08 V en CH2
Canal A (OUT1/OUT2) = motores izquierdos Canal B (OUT3/OUT4) = motores derechos (los 2 motores de cada lado en paralelo) Sacar los jumpers ENA/ENB. Dejar el jumper 5V del modulo y NO conectar su bornera +5V. 100 nF ceramico en bornes de cada motor.
ToF en 0x30/0x31/0x32 (asignadas con XSHUT): frente y laterales, piso de arriba. MPU6050 en 0x68 (AD0 a GND), piso de abajo, por cable. Las 4 lineas INT se usan (lectura por interrupcion).

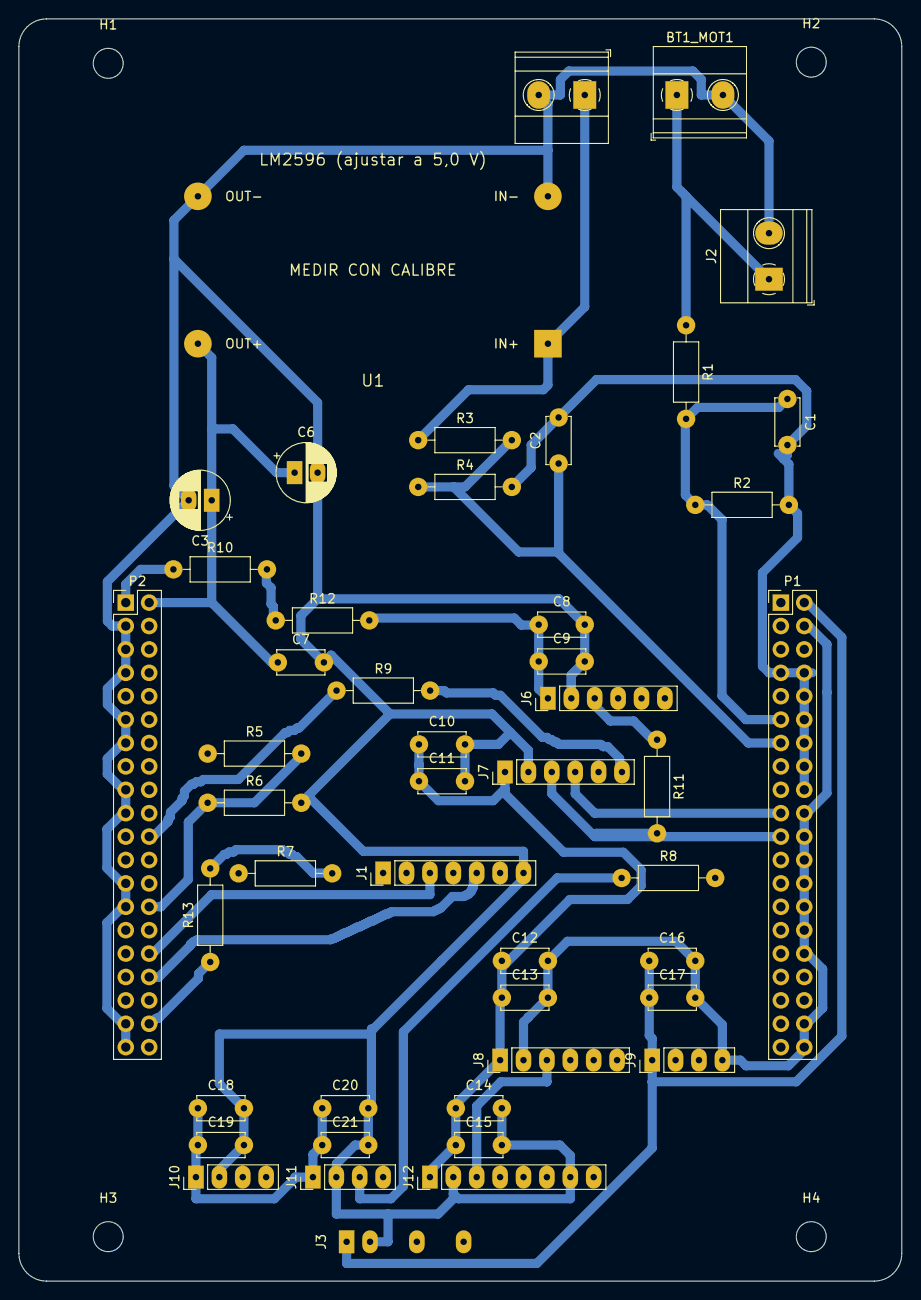
[picture p23: board auto_remoto.kicad_pcb from above]

Board: 2 copper layers, 95.9 x 137.0 mm, 51 parts (0 on the bottom side), 37 nets.

Other parts of the board:
H1, H2, H3, H4: M3; Agujero_M3
