RoverLabUNLP/PCB/(commit log)

2026-11-02 para Martiño gordiño
    [auto_remoto.kicad_pcb, auto_remoto.kicad_sch]
2026-11-05 mas avances
    [auto_remoto.kicad_pcb, auto_remoto.kicad_sch]
2026-11-05 poncho mas ancho
    [auto_remoto.kicad_pcb, auto_remoto.kicad_sch]
2026-11-05 poncho mas ancho pero falta
    [auto_remoto.kicad_pcb, auto_remoto.kicad_sch, auto_remoto_antes_de_limpiar_gnd.kicad_pcb, auto_remoto_antes_de_reintento.kicad_pcb]
